alex31/paparazzi_minican/README.md

# MicroCAN

MicroCAN is a flexible UAVCAN interface card based on an STM32G491 microcontroller. It acts as a proxy between a UAVCAN network and a variety of peripherals such as servos, ESCs, sensors and serial links. The project contains both the bootloader and the main firmware used on the board.

## Features

- **UAVCAN slave node** with CAN FD support
- **Bootloader** able to update the firmware from an external M95P SPI flash memory with CRC checks for reliability
- **Servo control**: standard PWM outputs and support for smart servos
- **DShot ESC driver** with optional bi‑directional telemetry
- **SBUS tunnel** to forward RC frames over UAVCAN
- **Telemetry tunnel** for Paparazzi messages or raw serial data
- **I2C sensor support** (e.g. MPL3115A2 barometer)
- **Independent sensors**: IM68A130 microphone, OPT4060 RGBW and VL53L4CX range
  ([configuration](docs/software/roles/independent_sensors.md))
- **Health survey** publishing battery and core temperature measurements
- Configurable roles and parameters stored in persistent memory

Hardware design files are available under [HARDWARE/](HARDWARE/).

## Repository layout

- [bootloader/](bootloader/) – bootloader source code and configuration
- [microcan/](microcan/) – main application implementing the UAVCAN node and all roles
- [COMMON/](COMMON/) – modules shared between bootloader and application
- [HARDWARE/](HARDWARE/) – hardware schematics and CubeMX configuration
- [docs/](docs/) – software and hardware documentation

## Documentation

Start here: [docs/index.md](docs/index.md)

Related references:
- [roles.readme.txt](roles.readme.txt)

## Building

A GNU Arm embedded toolchain and ChibiOS 21.11 are required. The Makefiles expect this repository to reside next to a `ChibiOS_21.11_stable` folder. Run:

```bash
make            # builds bootloader and firmware
make flash       # flashes both images using bmpflash
```

You can also build `bootloader` or `microcan` individually by invoking `make -C bootloader` or `make -C microcan`.

For the very first flash over the STM32 ROM UART bootloader with a 3.3 V USB to
serial adapter, see [docs/software/build_flash.md](docs/software/build_flash.md).

## License

The vendored VL53L4CX component retains its [ST license](third_party/vl53l4cx/LICENSE.md)
and [source provenance](third_party/vl53l4cx/README.microcan.md).

This project includes ChibiOS components released under the Apache License 2.0. The rest of the code is provided without any specific license.
