alex31/paparazzi_minican/docs/hardware/overview.md

# Hardware Overview

This section documents the hardware platform and board files.

Key board files:
- [microcan/cfg/MICROCAN.cfg](../../microcan/cfg/MICROCAN.cfg) (pin map)
- [HARDWARE/MICROCAN/](../../HARDWARE/MICROCAN/) (schematics and board docs)

Onboard RGB LED behavior is defined in software. See:
- [docs/software/onboard_rgb_led.md](../software/onboard_rgb_led.md)
