alex31/paparazzi_minican/docs/software/roles/overview.md

# Role System and Roles

Role system overview:
- Roles are modular features enabled by parameters.
- Roles are compiled in if USE_*_ROLE in
  [COMMON/source/roleConf.h](../../../COMMON/source/roleConf.h) is true. The diagnostic shell uses `TRACE` (omitted with `NOSHELL=1`).
- Roles are instantiated at startup if their ROLE.* parameter is enabled.
- When ROLE.identification is true **at boot**, application roles remain stopped and UAVCAN
  runs in MAINTENANCE mode. Configuration, restart, dynamic ID allocation and
  firmware updates remain available; the onboard LED shows the purple motif.
  The shell remains available if `ROLE.shell=true`.
  Role parameters remain visible and retain their values. Disable identification,
  save and restart to resume the configured roles without reconfiguring them.
- After a normal boot, changing ROLE.identification only toggles the onboard
  LED between identification and node ID. Roles and UAVCAN mode are unchanged;
  the value is read at intervals of at most 200 ms. Use parameter write behavior 0 for a temporary
  change; behavior 1 saves it for the next boot, and behavior 2 reboots at once.
- Each role inherits RoleBase and implements subscribe() and start().
- Hardware resources are acquired via boardResource.tryAcquire(...).

Source reference: [roles.readme.txt](../../../roles.readme.txt) and
[COMMON/source/](../../../COMMON/source/) (files named *Role*).

## Roles (summary)

### ShellRole (ROLE.shell)
Enables the diagnostic console on J3 / LPUART1 at 115200 bit/s, 8N1.
Defaults to false; save and reboot. Its command buffers, history, statistics and
two thread stacks are allocated on activation. It also starts in identification mode when enabled.
See [shell.md](shell.md) for memory details and the test procedure.

### ServoRole (ROLE.servo.pwm, ROLE.servo.smart)
Receives uavcan.equipment.actuator.ArrayCommand and routes to PWM or smart servo
backend.

PWM params:
- role.servo.pwm.ch1-4.frequency
- role.servo.pwm.ch1-4.shot125
- role.servo.pwm.ch5-7.frequency
- role.servo.pwm.ch5-7.shot125
- role.servo.pwm.map_index1
- role.servo.pwm.channel_mask
  Bit mapping: bit0=PA08, bit1=PA09, bit2=PA10, bit3=PA11, bit4=PB04, bit5=PA04, bit6=PB07.

Smart servo params:
- role.servo.smart.map_index1
- role.servo.smart.num_servos
- role.servo.smart.status_frequency

Outputs:
- uavcan.equipment.actuator.Status (smart servo status only)

Wiring:
- PWM CH1..CH4 on TIM1 (PA08..PA11)
- PWM CH5..CH7 on TIM3 (PB04, PA04, PB07)
- Smart servos use UART (USART2 on MicroCAN)

Resource notes:
- Enabling any of CH5..CH7 reserves TIM3 for ServoPWM.
- CH5 on PB04 conflicts with USART2 RX (`UART_RX`).
- CH6 on PA04 conflicts with SPI peripheral chip select (`SPI_PERIPH_CS`).
- CH7 on PB07 conflicts with I2C1 SDA and with roles already documented on TIM3_CH4
  (LED strip, voltmeter).
- If only CH1..CH4 are enabled, ServoPWM stays on TIM1 and does not reserve TIM3.

### EscDshot (ROLE.esc.dshot)
Receives uavcan.equipment.esc.RawCommand and drives DShot on TIM1 CH1..CH4.

Params:
- role.esc.dshot.map_index1
- role.esc.dshot.channel_mask
- role.esc.dshot.cmd_rate (ChibiOS ticks)
- role.esc.dshot.rpm_freq_div (CAN publication divider; 0 disables publication)
- role.esc.dshot.motor_poles (even number from 2 to 100, default 2; common to all motors)
  Set to the motor's pole count, e.g. 14 for a 14-pole motor, and reboot the node.
  The default preserves the previous RPM scale; configure the actual pole count
  to obtain mechanical RPM for your motors. Odd values prevent the role from starting.

Telemetry:
- uavcan.equipment.esc.Status if bidirectional DShot is enabled.
- Every active channel's eRPM/EDT response is processed on each DShot cycle,
  including when CAN publication is disabled. The divider only limits CAN output.
- At each publication interval, channels with a valid eRPM received during that
  interval publish their latest mechanical RPM (`eRPM / (motor_poles / 2)`, rounded
  down) and fresh EDT data. Temperature is converted from Celsius to kelvin;
  voltage and current are published in volts and amperes. Missing measurements
  or measurements at least 3 seconds old are published as NaN, independently.
- With EDT enabled, stress maxima and status events are also published through
  dronecan.protocol.FlexDebug, at most 10 Hz per ESC. See the
  [freshness rules and MicroCAN payload format](dshot_telemetry.md).

Wiring:
- TIM1 CH1..CH4 on PA08..PA11 (MicroCAN)

### SBUS RC (ROLE.sbus)
Reads SBUS on UART and publishes dronecan.sensors.rc.RCInput.

Params:
- role.sbus.channel_mask
- role.sbus.id
- role.sbus.debug_uart_ttl (true: non-inverted TTL debug input, false: normal SBUS inversion)

Wiring:
- SBUS on USART2 RX (PB04) on MicroCAN

### SerialStream (ROLE.tunnel.serial)
UART <-> uavcan.tunnel.Broadcast bridge.

Params:
- role.tunnel.serial.protocol
- bus.serial.baudrate

Wiring:
- USART2 TX/RX on PB03/PB04 (MicroCAN)

### GpsUBX (ROLE.gnss.ubx)
Decodes UBX from UART and publishes:
- uavcan.equipment.gnss.Fix2 (NAV-PVT)
- uavcan.equipment.gnss.Auxiliary (DOP/SAT)

Params:
- bus.serial.baudrate

Notes:
- `bus.serial.baudrate > 0`: fixed UART baudrate.
- `bus.serial.baudrate = 0`: GNSS UBX auto-baud probing on `57600`, `115200`, `230400`.
- Detect baud, then configure GPS while keeping that detected baud.

The C++ decoder stores its callback configuration by reference. Its constructor
accepts `UBX::StaticDecoderConf`, whose `consteval` conversion checks the binding
at the call site. Keep the configuration in static storage, as in the existing
`GpsUBX::config` (`inline static constexpr`). Automatic configurations, including
local `constexpr` variables, heap configurations and temporaries are rejected.
The decoder itself can still be allocated dynamically.

Any intermediate factory must accept `UBX::StaticDecoderConf` by value rather
than an unchecked `const UBX::DecoderConf&`, so the check occurs at the original
call site. The wrapper is not stored in addition to the reference and does not
add per-decoder RAM. It checks the configuration object's lifetime, not callback
behavior or initialization of mutable global configurations.

Run `make -C microcan test_ubx_config_lifetime` for the positive and negative
compilation tests using the ARM compiler and the actual decoder header.

Wiring:
- USART2 TX/RX on PB03/PB04 (MicroCAN)

### QMC5883 Magnetometer (ROLE.i2c.magnetometer.q5883)
Publishes uavcan.equipment.ahrs.MagneticFieldStrength2.

Params:
- role.i2c.magnetometer.q5883.range (2 or 8 gauss)
- role.i2c.magnetometer.q5883.rot_deg (0/90/180/270)
- role.i2c.magnetometer.q5883.sensor_id

Wiring:
- I2C1 on PA15 (SCL) + PB07 (SDA)

### MPL3115A2 Barometer (ROLE.i2c.barometer.mpl3115a2)
Publishes uavcan.equipment.air_data.StaticPressure and StaticTemperature.

Wiring:
- I2C1 on PA15 (SCL) + PB07 (SDA)

### HealthSurvey (ROLE.health.survey)
Publishes board health:
- uavcan.equipment.device.Temperature
- uavcan.equipment.power.CircuitStatus (battery + 3.3V)

### LED Strip (ROLE.led2812)
Receives uavcan.equipment.indication.LightsCommand to drive WS2812 strip.

Params:
- role.led2812.led_number (1..8)

Wiring:
- TIM3_CH4 on PB07 (shared with voltmeter)

### Voltmeter (ROLE.voltmeter)
Displays battery status on WS2812 LED strip. Can blank LEDs based on GPS speed.

Params:
- role.voltmeter.cells
- role.voltmeter.brightness
- role.voltmeter.gps_speed_off_mps

Wiring:
- TIM3_CH4 on PB07 (shared with LED strip)

### TemplateRole (ROLE.template)
Minimal example role for developers. Subscribes to uavcan.protocol.NodeStatus and
optionally logs every N messages.

Params:
- role.template.log_every (0 disables logging)

See [docs/software/adding_roles.md](../adding_roles.md) for the full new role checklist.

## Independent microphone, RGBW and distance sensors

- `MicrophoneRole`: `ROLE.adc.microphone.im68a130`, PA4/ADC2/TIM6; electrical
  512-point Hann FFT and top-ten 100 Hz–3 kHz bins over
  `microcan.audio.Spectrum` (ID 20900): uint16 Hz and logarithmic uint16 level;
  the generic wire format supports up to 255 bins.
- `Opt4060Role`: `ROLE.i2c.light.opt4060`, shared I2C1 and optional PA8 INT;
  CRC-checked RGBW readings over `uavcan.protocol.debug.KeyValue`.
- `Vl53l4cxRole`: `ROLE.i2c.range.vl53l4cx`, shared I2C1;
  `uavcan.equipment.range_sensor.Measurement` in metres.

All are disabled by default and independent of IMAV. See
[independent sensors](independent_sensors.md) for parameters, telemetry units,
error handling and pin conflicts.
