alex31/paparazzi_minican/docs/hardware/boards/microcan_v5.md

# MicroCAN v5

Board: MicroCAN v5 (STM32G491K, 170 MHz, single-precision FPU).

Core peripherals:
- CAN FD with software selectable terminal resistor
- UART for GPS, serial tunnel, smart servo, etc.
- I2C for external peripherals, software selectable pullups
- SPI shared between internal M95P EEPROM and external peripherals
- TIM/PWM for servo, DShot, RGB LED strip
- Onboard RGB LED for node ID and status
- Debug pads with SWD and UART
- ADC monitoring for battery and 5V

Key files:
- [microcan/cfg/MICROCAN.cfg](../../../microcan/cfg/MICROCAN.cfg) (pin map)
- [HARDWARE/MICROCAN/](../../../HARDWARE/MICROCAN/) (schematics)
