alex31/paparazzi_minican/docs/software/compilation_toggles.md

# Compilation Toggles

Compile-time role toggles are defined in
[COMMON/source/roleConf.h](../../COMMON/source/roleConf.h):
- USE_SERVO_ROLE
- USE_BARO_MPL3115A2_ROLE
- USE_QMC5883_ROLE
- USE_ESC_DSHOT_ROLE
- USE_RC_SBUS_ROLE
- USE_GPS_UBX_ROLE
- USE_SERIAL_STREAM_ROLE
- USE_LED2812_ROLE
- USE_VOLTMETER_ROLE
- USE_TEMPLATE_ROLE
- USE_MICROPHONE_ROLE
- USE_OPT4060_ROLE
- USE_VL53L4CX_ROLE

These must be enabled for roles to be compiled in. Runtime enable is separate
and controlled by ROLE.* parameters.

The three new sensor switches accept make overrides (`USE_OPT4060_ROLE=0`,
for example). Use `make -C microcan clean` before changing make overrides.
They default to compiled-in, but their `ROLE.*` parameters
are false by default. See [independent sensors](roles/independent_sensors.md).
