alex31/paparazzi_minican/IMAV/sensors_electronic.odt

# Carte capteurs IMAV — document de travail

Version de discussion du 22 juillet 2026

Cible : MicroCAN v5 / STM32G491

Statut : proposition pour le premier prototype, à commenter en équipe

## 1. Balise cible et cadre IMAV 2026

### 1.1 Ce que fixe le règlement

La source de référence est le règlement IMAV 2026 v2.1, sections 5.4.7 et 5.4.8, page 34.

Sujet | Donnée utile pour le projet
Balise annoncée | MSA motionSCOUT K-T-R
Signal sonore | bande 2,6 à 3,0 kHz ; alarme annoncée à 95 dB à 3 m
Signal lumineux | deux LED très lumineuses ; le règlement ne précise ni leur couleur ni leur chronogramme
Zone de recherche | un point GPS donné le jour de l'épreuve ; trois mannequins dans un rayon de 25 m
Cible | un seul des trois mannequins porte la balise
Dépose | colis déposé ou largué à moins de 2 m d'altitude ; distance mesurée du nombril au colis, limitée à 50–300 cm pour le calcul
Enjeu de la détection | la partie principale du score est multipliée par deux près du bon mannequin
Autonomie | facteur 1 si tout est autonome, 0,7 avec calcul hors bord et 0,4 en cas d'action manuelle

Le texte conserve la mention « puissance sonore à définir » tout en donnant 95 dB à 3 m entre parenthèses. Cette valeur est donc notre base de travail, mais elle mérite une confirmation de l'organisation.

### 1.2 Comportement de la motionSCOUT K-T-R

Le manuel MSA 10251777/01 couvre toute la famille motionSCOUT et pas uniquement la balise de la compétition. Son tableau de commande associe explicitement la version motionSCOUT K avec les options T-R à la référence 10088478. C'est donc bien la variante visée par le règlement : version à clé (K), avec capteur de température (T) et réinitialisation manuelle de l'alarme (R).

D'après ce manuel :

1. le retrait de la clé active l'appareil et lance un autotest sonore et lumineux d'environ 2 s ;
2. après 25 s sans mouvement, une préalarme dure environ 15 s ; elle émet deux signaux sonores par seconde à niveau croissant et s'annule dès que la balise bouge ;
3. si l'immobilité continue, l'alarme complète démarre, soit environ 40 s après le dernier mouvement ; elle peut aussi être déclenchée immédiatement par le bouton d'alarme ;
4. l'alarme complète émet trois signaux sonores par seconde au niveau maximal et active les deux LED rouges d'alarme ; le manuel ne donne pas la cadence de ces LED ;
5. sur cette version R, deux appuis sur le bouton d'alarme en moins d'une seconde réinitialisent l'alarme ;
6. pour éteindre la version à clé, il faut réinsérer la clé puis maintenir le bouton ON/OFF pendant au moins 4 s.

La balise possède deux LED rouges d'alarme et une LED bicolore d'état distincte.

Une vidéo de démonstration de la motionSCOUT (https://www.youtube.com/shorts/VTjL53YFpTA) montre les deux LED d'alarme allumées simultanément pendant des impulsions de l'ordre de 100 ms, avec des cadences voisines de 1, puis 2, puis 3 allumages par seconde au cours de la séquence. Cette durée est assez longue pour une acquisition couleur périodique sans FIFO. La vidéo ne documente toutefois ni la référence exacte ni les conditions de prise de vue : ces valeurs sont des indications pour le prototype, pas des caractéristiques garanties de la balise de compétition.

La brochure MSA indique une bande de 2,6 à 3,0 kHz, comme le règlement, tandis que le manuel donne une bande plus large de 2,0 à 3,0 kHz. Le firmware utilise donc 2 600 Hz par défaut, conformément au règlement, mais expose le paramètre persistant role.imav.audio.band_low_hz, réglable de 2 000 à 2 600 Hz. La borne haute reste fixée à 3 000 Hz. La grille DSP ajoute une marge de 50 Hz de chaque côté et le nouveau réglage est pris en compte au redémarrage du rôle, donc en pratique après redémarrage de la MicroCAN.

Sources fabricant : brochure motionSCOUT (https://s7d9.scene7.com/is/content/minesafetyappliances/motionSCOUT%20Bulletin%20-%20FR), manuel MSA 10251777/01 et avis de service de février 2026 (https://assetlibrary.msasafety.com/m/1daafc2b15a7c2a5/original/Avis-de-service-Dispositif-MSA-motionSCOUT-PASS-Fevrier-2026.pdf).

Source d'observation complémentaire : vidéo YouTube de démonstration (https://www.youtube.com/shorts/VTjL53YFpTA).

### 1.3 Points à confirmer sur la balise de compétition

Le règlement et les documents MSA ne définissent pas :

- l'orientation et la fixation de la balise sur le mannequin ;
- les conditions réelles de soleil, de bruit, de vent et d'occultation pendant la mission ;

Il faut donc demander si possible une balise identique pour les essais, ou au minimum enregistrer l'exemplaire de compétition sous plusieurs angles et à plusieurs distances.

Un avis de service MSA de février 2026 inclut la référence 10088478 fabriquée entre juin 2024 et décembre 2025 : sur certaines unités, l'alarme sonore peut cesser alors que l'alarme visuelle continue de clignoter.

### 1.4 Conséquences pour notre détecteur

- La voie audio utilisera par défaut l'énergie dans la bande 2,6–3,0 kHz, mais sa borne basse pourra être abaissée jusqu'à 2,0 kHz pour les essais. La cadence caractéristique de trois signaux par seconde reste indispensable.
- La voie optique cherchera des variations rouges rapides et répétées. Une acquisition voisine de 100 Hz donnera environ dix mesures pendant un allumage de 100 ms observé dans la vidéo, sans imposer de FIFO.
- La LED d'état à 1 Hz n'est pas un indice de présence de la balise. Son éventuelle contribution au signal du capteur est un parasite qui ne doit pas déclencher la détection.
- Les détections sonore et lumineuse resteront indépendantes : leur accord augmentera la confiance, mais un ET strict risquerait de rejeter une vraie balise.
- L'exclusion temporelle entre mesure de lumière et mesure ToF ne sera validée qu'après mesure de la répétition réelle des éclairs et de la fenêtre aveugle.
- Comme une seule cible doit être distinguée parmi trois mannequins, la décision devra s'appuyer sur plusieurs mesures cohérentes dans l'espace, pas sur une détection instantanée isolée.

## 2. Contexte

Le module sera suspendu sous le drone par un fil de 2 à 3 m. Le drone volera à environ 3 à 4 m et la carte capteurs se trouvera approximativement à 1 m du sol. Elle doit aider à retrouver un mannequin couché équipé d'une balise sonore et lumineuse.

Le signal utile venant du sol, la proposition la plus simple est d'utiliser un seul capteur par fonction, tous orientés ou ouverts vers le bas :

- un microphone pour la balise sonore ;
- un capteur rapide pour les flashs ;
- un télémètre pour contrôler la hauteur du module au-dessus du sol.

Ce document présente la solution actuellement envisagée. Il ne constitue pas encore une spécification de fabrication définitive.

## 3. Proposition actuelle

Fonction | Composant retenu | Interface | Motivation principale
Son | Infineon IM68A130A | PA3 / ADC1_IN4 | microphone analogique sensible, un seul canal ADC
Flash | Texas Instruments OPT4060DTSR | I²C, adresse 0x44 | RGBW, forte réjection IR, plage automatique et alimentation directe en 3,3 V
Distance au sol | ST VL53L4CXV0DH/1 | I²C, adresse 0x29 | portée suffisante autour de 1 m et pilote officiel ST

Décisions déjà raisonnablement établies :

- un seul microphone et un seul capteur de flash ;
- OPT4060 et VL53L4CX orientés vers le sol ;
- microphone relié directement à l'ADC, sans amplificateur externe ;
- OPT4060 et VL53L4CX sur le même bus I²C ;
- bus à 400 kHz pour le premier prototype ;
- pull-up I²C de 2,2 kΩ déjà présentes sur la MicroCAN ;
- aucune mesure de lumière pendant une mesure ToF ;
- tous les capteurs alimentés directement par le rail 3,3 V ;
- acquisition du capteur de lumière par lecture périodique, sans FIFO ;
- sortie d'interruption de l'OPT4060 facultative pour le premier prototype.

Ce choix supprime le régulateur 1,8 V et la dépendance au TCS34103M en phase « Last Time Buy ». Il conserve une information de couleur utile pour distinguer les LED rouges de variations générales de l'éclairage ambiant.

## 4. Utilisation envisagée des capteurs

### 4.1 Microphone

L'IM68A130A fournit déjà un signal analogique amplifié et polarisé autour de 1,3 V. Il peut donc être relié directement à l'ADC 0–3,3 V :

- pas de condensateur de liaison ;
- pas de pont de polarisation ;
- pas d'OPAMP ;
- un simple filtrage passif de l'alimentation et une petite résistance série devant l'ADC.

L'indicateur sonore proposé pour discriminer la balise du bruit des moteurs est le rapport :

10 × log10(énergie dans les bandes de la balise / énergie audio totale)

La borne basse utilisée par ce calcul vient de role.imav.audio.band_low_hz : plage 2 000–2 600 Hz, valeur par défaut 2 600 Hz. Ce paramètre est exposé par UAVCAN et sauvegardé dans la mémoire persistante avec le mécanisme commun de la MicroCAN. Un redémarrage est requis après sa modification.

Il faudra lui ajouter un seuil minimal d'énergie absolue pour éviter qu'un rapport élevé calculé sur du silence soit interprété comme une détection. Les largeurs de bandes et les seuils devront être déterminés à partir d'enregistrements réels sous le drone. La présence d'une enveloppe répétée à environ 3 Hz permettra de renforcer la détection de l'alarme complète ; la préalarme à 2 Hz ne doit pas être notre état nominal de recherche.

### 4.2 Flash

L'OPT4060 fonctionne directement sous 3,3 V et fournit quatre voies : rouge, verte, bleue et large bande. Les voies RGB possèdent une forte réjection du proche infrarouge. La sélection automatique de plage doit faciliter le passage de l'ombre au soleil sans réglage permanent du gain.

Pour le premier prototype, la configuration proposée est :

- temps de conversion de 1,8 ms par voie, soit 7,2 ms pour un cycle RGBW ;
- mode continu et lecture périodique proche de 100 Hz sur l'I²C à 400 kHz ;
- plage automatique activée ;
- pas de FIFO et pas d'interruption obligatoire.

À 100 Hz, un allumage d'environ 100 ms observé dans la vidéo produit une dizaine de mesures. La détection pourra combiner :

- une variation positive de la voie rouge par rapport à un fond ambiant lent ;
- un seuil minimal absolu pour rejeter le bruit de mesure ;
- une chromaticité dominée par le rouge, comparée aux voies verte, bleue et large bande ;
- la répétition temporelle attendue de l'alarme complète, voisine de 3 Hz.

La LED d'état rouge à 1 Hz ne devra jamais suffire à valider la détection. Les seuils et les rapports de couleur seront déterminés à partir de mesures sur la vraie balise, en intérieur puis en plein soleil.

### 4.3 Distance au sol

Le VL53L4CX effectuera une mesure ponctuelle, typiquement toutes les 200 ms. L'acquisition de l'OPT4060 sera suspendue avant l'émission infrarouge 940 nm, puis reprise après la mesure. Les échantillons optiques présents autour de cette fenêtre seront ignorés.

Cette stratégie simplifie l'électronique et évite les interactions optiques, mais crée une fenêtre aveugle de plusieurs dizaines de millisecondes pour les flashs. Les allumages assez longs visibles dans la vidéo rendent cette stratégie plausible, mais son acceptabilité devra être vérifiée sur la vraie balise.

## 5. Schéma électrique minimal proposé

+3V3 --------------------------------------------------------------+
| |
+-- 10 µF + 100 nF près du connecteur |
| |
+-- 22 Ω -- IM68A130A VDD |
| +-- 1 µF + 100 nF vers GND |
| |
+---------------------------- OPT4060 VDD |
| +-- 100 nF vers GND |
| |
+---------------------------- VL53L4CX AVDD + AVDDVCSEL |
+-- 100 nF + 4,7 µF vers GND |
|
IM68A130A OUT -- 100 Ω -- MIC_ADC -- PA3 / ADC1_IN4 |
|
OPT4060 ADDR ------------------------------------------------ GND |
OPT4060 INT ------------------------------------------ point de test|
|
MicroCAN SDA ------------------- OPT4060 SDA + VL53L4CX SDA |
MicroCAN SCL ------------------- OPT4060 SCL + VL53L4CX SCL |
GND ------------------------------------------------ plan continu --+

Points à conserver dans le schéma du premier prototype :

Élément | Proposition de départ
Entrée 3,3 V | 10 µF + 100 nF près du connecteur
Microphone | alimentation via 22 Ω, 1 µF + 100 nF, sortie via 100 Ω
Filtre ADC optionnel | empreinte 47 à 100 pF, non montée initialement
OPT4060 | VDD sur 3,3 V, 100 nF au plus près, ADDR à GND pour l'adresse 0x44
OPT4060 INT | point de test ou broche optionnelle, non nécessaire au fonctionnement initial
VL53L4CX | 100 nF + 4,7 µF, XSHUT tiré à 3,3 V par 10 kΩ
SDA/SCL | résistances série 0 Ω ; pull-up locales prévues mais non montées

Le VL53L4CX impose les pointes de courant les plus fortes. Le connecteur, le faisceau et le rail 3,3 V seront dimensionnés pour au moins 60 mA.

## 6. Connexion à la MicroCAN

La proposition utilise un connecteur verrouillable à six contacts et un petit faisceau en Y vers J3 et J5 de la MicroCAN.

Signal carte capteurs | Destination MicroCAN
GND_AUDIO | J3 broche 1
MIC_ADC | J3 broche 7 — PA3 / ADC1_IN4
GND_I2C | J5 broche 1
+3V3 | J5 broche 3
SDA | J5 broche 4 — PB7 / I2C1_SDA
SCL | J5 broche 5 — PA15 / I2C1_SCL

Le +5 V de J5 n'est pas utilisé. MIC_ADC devra cheminer avec GND_AUDIO et être tenu à distance des fils moteur, PWM et alimentation de puissance.

La famille exacte du connecteur reste à choisir avec l'équipe mécanique et en fonction des connecteurs réellement montés sur la MicroCAN.

## 7. Implantation mécanique proposée

- OPT4060 et VL53L4CX sur la face inférieure, orientés vers le sol.
- Cloison noire entre les deux capteurs optiques.
- Microphone sur l'autre face avec un trou acoustique non métallisé de 0,6 mm vers le sol, sous réserve de validation de la variante exacte du microphone.
- Aucun composant, vernis, colle ou sérigraphie devant les surfaces sensibles.
- Keep-out séparés pour les deux zones optiques et le trou acoustique.
- Pour le premier prototype, ouvertures directes sans vitre ni diffuseur afin de limiter les inconnues.
- Une carte quatre couches est préférable pour conserver un plan de masse continu, mais une carte deux couches reste à discuter si la géométrie est simple.

Les dimensions de carte, les fixations, la masse cible et la protection contre le vent ne sont pas encore définies.

## 8. Disponibilité observée au 22 juillet 2026

Les stocks évoluent rapidement ; ce tableau sert uniquement à éviter de figer une référence impossible à acheter en petite quantité.

Référence | Situation observée | Conséquence proposée
IM68A130AXTMA1 (https://www.digikey.fr/fr/products/detail/infineon-technologies/IM68A130AXTMA1/20115168) | actif, mais stock nul chez Mouser et DigiKey lors de la vérification | vérifier un autre distributeur ou la variante V01
IM68A130V01XTMA1 (https://www.mouser.fr/ProductDetail/Infineon-Technologies/IM68A130V01XTMA1) | actif et préféré, environ 4 100 pièces chez Mouser, vente à l'unité | candidat de remplacement à valider mécaniquement
OPT4060DTSR (https://www.digikey.com/en/products/detail/texas-instruments/OPT4060DTSR/22116843) | actif, plusieurs milliers de pièces disponibles à l'unité chez DigiKey et Mouser | choix retenu pour le capteur de flash
APDS-9253-001 (https://www.digikey.com/en/products/detail/broadcom-limited/APDS-9253-001/10135044) | actif, plusieurs milliers de pièces disponibles à l'unité | repli RGB + IR sous 3,3 V, limité à environ 40 mesures/s
VEML3328 (https://www.mouser.com/ProductDetail/Vishay-Semiconductors/VEML3328) | actif et très largement disponible | repli très simple, mais intégration minimale de 50 ms
TCS34103M / Q65114A1293 (https://www.digikey.com/en/products/detail/ams-osram-usa-inc/TCS34103M-OLGA6-LF-T-RDP/14123872) | disponible mais en phase Last Time Buy | écarté : rail 1,8 V et FIFO devenus inutiles
VL53L4CXV0DH/1 (https://www.mouser.com/ProductDetail/STMicroelectronics/VL53L4CXV0DH-1) | plusieurs milliers de pièces chez Mouser et Farnell | pas de risque immédiat identifié

Le choix fonctionnel du microphone reste la famille IM68A130. Avant de libérer le PCB, il faudra confirmer si la qualification automobile de l'IM68A130A est utile pour cette compétition ou si l'IM68A130V01, beaucoup plus disponible, convient. Le symbole, le port acoustique et le land pattern devront être comparés sur les fiches techniques officielles avant substitution.

## 9. Questions à discuter

## 10. Essais proposés avant de figer la carte

- Est-ce qu’on aura une balise pour faire des tests à l’Enac ?

## 11. Documents de référence

Documents du projet :

- étude système ;
- schéma MicroCAN v5 ;
- acquisition et détection audio ;
- gestion lumière et distance.

Fiches fabricants :

- Infineon IM68A130A (https://www.infineon.com/assets/row/public/documents/24/49/infineon-im68a130a-datasheet-en.pdf) ;
- Infineon IM68A130V01 (https://www.infineon.com/assets/row/public/documents/24/49/infineon-im68a130-datasheet-en.pdf) ;
- Texas Instruments OPT4060 (https://www.ti.com/lit/ds/symlink/opt4060.pdf) ;
- Broadcom APDS-9253-001 (https://www.broadcom.com/products/optical-sensors/ambient-light-photo-sensors/apds-9253-001) ;
- Vishay VEML3328 (https://www.vishay.com/docs/84968/veml3328.pdf) ;
- ST VL53L4CX (https://www.st.com/resource/en/datasheet/vl53l4cx.pdf).

Observation vidéo non normative :

- vidéo YouTube de démonstration de la motionSCOUT (https://www.youtube.com/shorts/VTjL53YFpTA).
