alex31/paparazzi_minican/HARDWARE/MICROCAN/MicroCAN_v5.pdf

28/07/2025

MiniCAN_v5 Project
Configuration Report

## 1. Description

### 1.1. Project

Project Name | MiniCAN_v5
Board Name | custom
Generated with: | STM32CubeMX 6.15.0
Date | 07/28/2025

### 1.2. MCU

MCU Series | STM32G4
MCU Line | STM32G4x1
MCU name | STM32G491KEUx
MCU Package | UFQFPN32
MCU Pin number | 32

### 1.3. Core(s) information

Core(s) | ARM Cortex-M4

## 2. Pinout Configuration

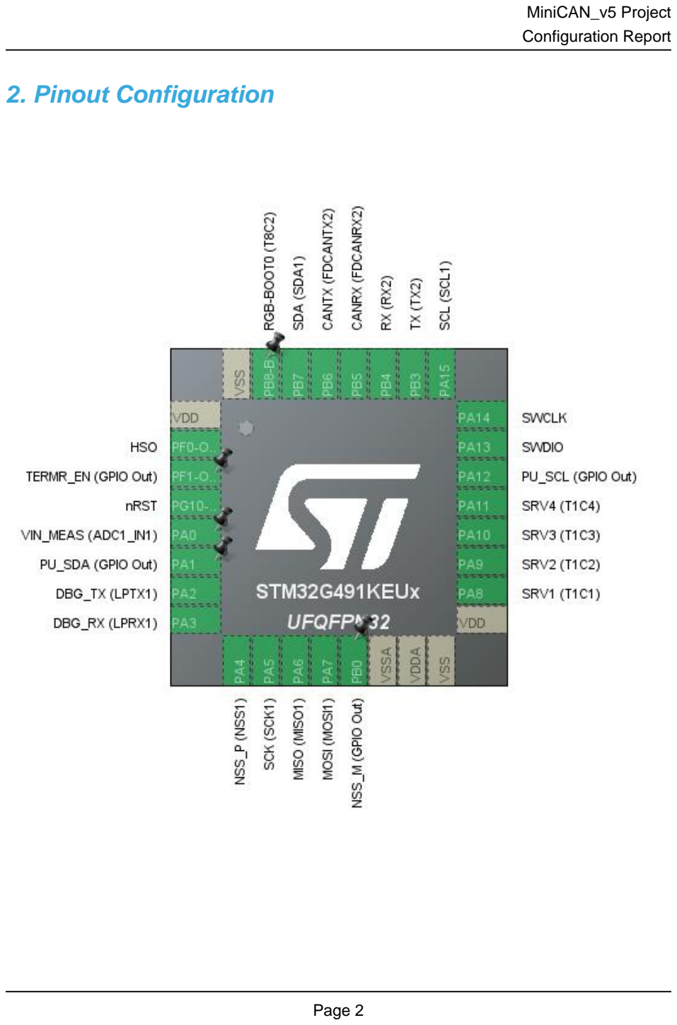
[picture p2: page 3]

## 3. Pins Configuration

Pin Number UFQFPN32 | Pin Name (function after reset) | Pin Type | Alternate Function(s) | Label
1 | VDD | Power
2 | PF0-OSC_IN | I/O | RCC_OSC_IN | HSO
3 | PF1-OSC_OUT * | I/O | GPIO_Output | TERMR_EN (GPIO Out)
4 | PG10-NRST * | I/O | GPIO_Input | nRST
5 | PA0 | I/O | ADC1_IN1 | VIN_MEAS (ADC1_IN1)
6 | PA1 * | I/O | GPIO_Output | PU_SDA (GPIO Out)
7 | PA2 | I/O | LPUART1_TX | DBG_TX (LPTX1)
8 | PA3 | I/O | LPUART1_RX | DBG_RX (LPRX1)
9 | PA4 | I/O | SPI1_NSS | NSS_P (NSS1)
10 | PA5 | I/O | SPI1_SCK | SCK (SCK1)
11 | PA6 | I/O | SPI1_MISO | MISO (MISO1)
12 | PA7 | I/O | SPI1_MOSI | MOSI (MOSI1)
13 | PB0 * | I/O | GPIO_Output | NSS_M (GPIO Out)
14 | VSSA | Power
15 | VDDA | Power
16 | VSS | Power
17 | VDD | Power
18 | PA8 | I/O | TIM1_CH1 | SRV1 (T1C1)
19 | PA9 | I/O | TIM1_CH2 | SRV2 (T1C2)
20 | PA10 | I/O | TIM1_CH3 | SRV3 (T1C3)
21 | PA11 | I/O | TIM1_CH4 | SRV4 (T1C4)
22 | PA12 * | I/O | GPIO_Output | PU_SCL (GPIO Out)
23 | PA13 | I/O | SYS_JTMS-SWDIO | SWDIO
24 | PA14 | I/O | SYS_JTCK-SWCLK | SWCLK
25 | PA15 | I/O | I2C1_SCL | SCL (SCL1)
26 | PB3 | I/O | USART2_TX | TX (TX2)
27 | PB4 | I/O | USART2_RX | RX (RX2)
28 | PB5 | I/O | FDCAN2_RX | CANRX (FDCANRX2)
29 | PB6 | I/O | FDCAN2_TX | CANTX (FDCANTX2)
30 | PB7 | I/O | I2C1_SDA | SDA (SDA1)
31 | PB8-BOOT0 | I/O | TIM8_CH2 | RGB-BOOT0 (T8C2)
32 | VSS | Power

* The pin is affected with an I/O function

## 4. Clock Tree Configuration

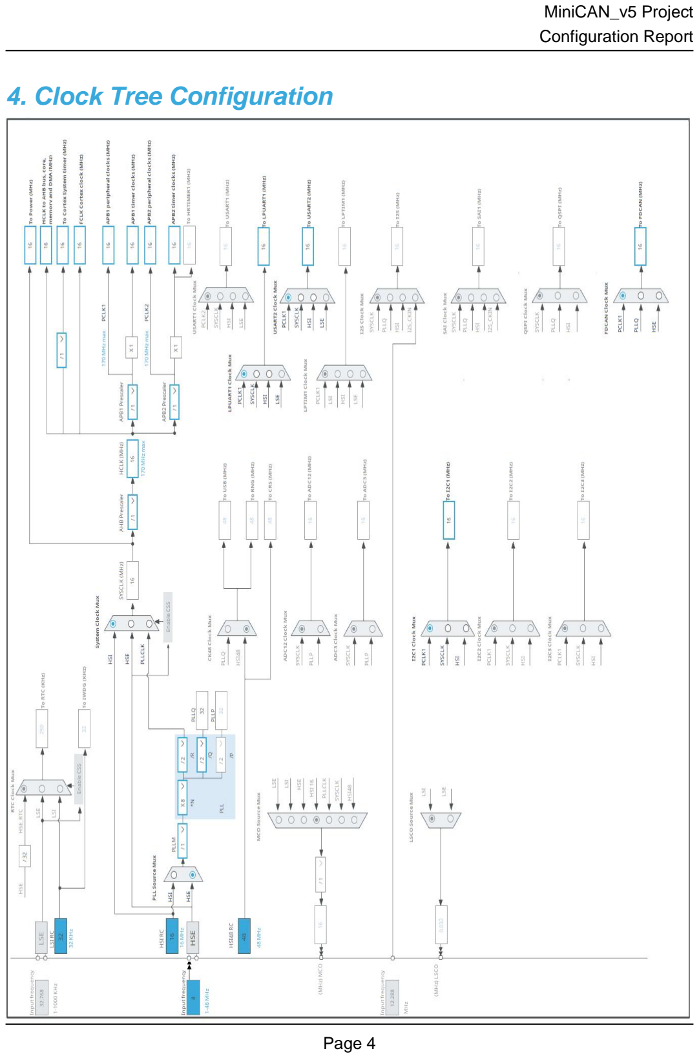
[picture p3: page 5]

## 1. Power Consumption Calculator report

### 1.1. Microcontroller Selection

Series | STM32G4
Line | STM32G4x1
MCU | STM32G491KEUx
Datasheet | DS13122_Rev1

### 1.2. Parameter Selection

Temperature | 25
Vdd | 3.3

### 1.3. Battery Selection

Battery | Li-SOCL2(A3400)
Capacity | 3400.0 mAh
Self Discharge | 0.08 %/month
Nominal Voltage | 3.6 V
Max Cont Current | 100.0 mA
Max Pulse Current | 200.0 mA
Cells in series | 1
Cells in parallel | 1

### 1.4. Sequence

Step | Step1 | Step2
Mode | RUN | STOP1
Vdd | 3.3 | 3.3
Voltage Source | Battery | Battery
Range | Range1-Boost | NoRange
Fetch Type | FLASH/ART | NA
CPU Frequency | 170 MHz | 0 Hz
Clock Configuration | HSE BYP PLL | LSE LowDrive RTC
Clock Source Frequency | 4 MHz | 32.768 kHz
Peripherals
Additional Cons. | 0 mA | 0 mA
Average Current | 26.4 mA | 57.3 µA
Duration | 0.1 ms | 0.9 ms
DMIPS | 213.0 | 0.0
Ta Max | 145.21 | 149.99
Category | In DS Table | In DS Table

### 1.5. Results

Sequence Time | 1 ms | Average Current | 2.69 mA
Battery Life | 1 month, 22 days, 3 hours | Average DMIPS | 212.5 DMIPS

### 1.6. Chart

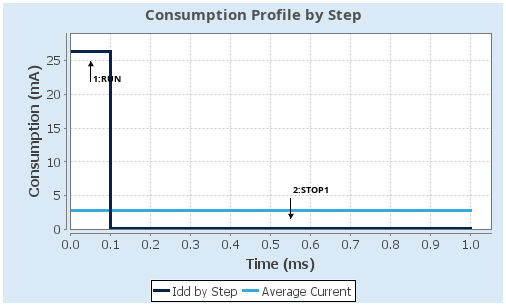
[picture p4: figure]

## 2. Software Project

### 2.1. Project Settings

Name | Value
Project Name | MiniCAN_v5
Project Folder | /home/alex/DEV/STM32/CHIBIOS/C21DEV/MINICAN/MINICAN_V5_MICROCAN
Toolchain / IDE | EWARM V8.50
Firmware Package Name and Version | STM32Cube FW_G4 V1.6.1
Application Structure | Advanced
Generate Under Root | No
Do not generate the main() | No
Minimum Heap Size | 0x200
Minimum Stack Size | 0x400

### 2.2. Code Generation Settings

Name | Value
STM32Cube MCU packages and embedded software | Copy all used libraries into the project folder
Generate peripheral initialization as a pair of '.c/.h' files | No
Backup previously generated files when re-generating | No
Keep User Code when re-generating | Yes
Delete previously generated files when not re-generated | Yes
Set all free pins as analog (to optimize the power consumption) | No
Enable Full Assert | No

### 2.3. Advanced Settings - Generated Function Calls

Rank | Function Name | Peripheral Instance Name
1 | SystemClock_Config | RCC
2 | MX_GPIO_Init | GPIO
3 | MX_LPUART1_UART_Init | LPUART1
4 | MX_TIM1_Init | TIM1
5 | MX_FDCAN2_Init | FDCAN2
6 | MX_I2C1_Init | I2C1
7 | MX_USART2_UART_Init | USART2
8 | MX_SPI1_Init | SPI1
9 | MX_ADC1_Init | ADC1
10 | MX_TIM8_Init | TIM8

## 3. Peripherals and Middlewares Configuration

### 3.1. ADC1

IN1: IN1 Single-ended
3.1.1. Parameter Settings:

ADCs_Common_Settings:

Mode | Independent mode
ADC_Settings:
Clock Prescaler | Synchronous clock mode divided by 2
Resolution | ADC 12-bit resolution
Data Alignment | Right alignment
Gain Compensation | 0
Scan Conversion Mode | Disabled
End Of Conversion Selection | End of single conversion
Low Power Auto Wait | Disabled
Continuous Conversion Mode | Disabled
Discontinuous Conversion Mode | Disabled
DMA Continuous Requests | Disabled
Overrun behaviour | Overrun data preserved
ADC_Regular_ConversionMode:
Enable Regular Conversions | Enable
Enable Regular Oversampling | Disable
Number Of Conversion | 1
External Trigger Conversion Source | Regular Conversion launched by software
External Trigger Conversion Edge | None
Rank | 1
Channel | Channel 1
Sampling Time | 2.5 Cycles
Offset Number | No offset
ADC_Injected_ConversionMode:
Enable Injected Conversions | Disable
Analog Watchdog 1:
Enable Analog WatchDog1 Mode | false
Analog Watchdog 2:
Enable Analog WatchDog2 Mode | false
Analog Watchdog 3:
Enable Analog WatchDog3 Mode | false

### 3.2. FDCAN2

mode: Activated
3.2.1. Parameter Settings:

Basic Parameters:

Clock Divider | Divide kernel clock by 1
Frame Format | Classic mode
Mode | Normal mode
Auto Retransmission | Disable
Transmit Pause | Disable
Protocol Exception | Disable
Nominal Sync Jump Width | 1
Data Prescaler | 1
Data Sync Jump Width | 1
Data Time Seg1 | 1
Data Time Seg2 | 1
Std Filters Nbr | 0
Ext Filters Nbr | 0
Tx Fifo Queue Mode | FIFO mode
Bit Timings Parameters:
Nominal Prescaler | 16
Nominal Time Quantum | 1000.0 *
Nominal Time Seg1 | 1
Nominal Time Seg2 | 1
Nominal Time for one Bit | 3000 *
Nominal Baud Rate | 333333 *

### 3.3. I2C1

I2C: I2C
3.3.1. Parameter Settings:

Timing configuration:

Custom Timing | Disabled
I2C Speed Mode | Standard Mode
I2C Speed Frequency (KHz) | 100
Rise Time (ns) | 100
Fall Time (ns) | 100
Coefficient of Digital Filter | 0

Analog Filter | Enabled
Timing | 0x00303D5B
Slave Features:
Clock No Stretch Mode | Disabled
General Call Address Detection | Disabled
Primary Address Length selection | 7-bit
Dual Address Acknowledged | Disabled
Primary slave address | 0

### 3.4. LPUART1

Mode: Asynchronous
3.4.1. Parameter Settings:

Basic Parameters:

Baud Rate | 209700
Word Length | 8 Bits (including Parity)
Parity | None
Stop Bits | 1
Advanced Parameters:
Data Direction | Receive and Transmit
Single Sample | Disable
ClockPrescaler | 1
Fifo Mode | FIFO mode disable
Txfifo Threshold | 1 eighth full configuration
Rxfifo Threshold | 1 eighth full configuration
Advanced Features:
TX Pin Active Level Inversion | Disable
RX Pin Active Level Inversion | Disable
Data Inversion | Disable
TX and RX pins Swapping | Disable
Overrun | Enable
DMA on RX Error | Enable
MSB First | Disable

### 3.5. RCC

High Speed Clock (HSE): BYPASS Clock Source
3.5.1. Parameter Settings:

System Parameters:

VDD voltage (V) | 3.3
Instruction Cache | Enabled
Prefetch Buffer | Disabled
Data Cache | Enabled
Flash Latency(WS) | 0 WS (1 CPU cycle)
RCC Parameters:
HSI Calibration Value | 64
HSE Startup Timout Value (ms) | 100
LSE Startup Timout Value (ms) | 5000
Power Parameters:
Power Regulator Voltage Scale | Power Regulator Voltage Scale 1
Peripherals Clock Configuration:
Generate the peripherals clock configuration | TRUE

### 3.6. SPI1

Mode: Full-Duplex Slave
Hardware NSS Signal: Hardware NSS Input Signal
3.6.1. Parameter Settings:

Basic Parameters:

Frame Format | Motorola
Data Size | 4 Bits
First Bit | MSB First
Clock Parameters:
Clock Polarity (CPOL) | Low
Clock Phase (CPHA) | 1 Edge
Advanced Parameters:
CRC Calculation | Disabled
NSS Signal Type | Input Hardware

### 3.7. SYS

Debug: Serial Wire
Timebase Source: SysTick
mode: save power of non-active UCPD - deactive Dead Battery pull-up

### 3.8. TIM1

Channel1: PWM Generation CH1 Channel2: PWM Generation CH2 Channel3: PWM Generation CH3 Channel4: PWM Generation CH4
3.8.1. Parameter Settings:

Counter Settings:

Prescaler (PSC - 16 bits value) | 0
Counter Mode | Up
Dithering | Disable
Counter Period (AutoReload Register - 16 bits value ) | 65535
Internal Clock Division (CKD) | No Division
Repetition Counter (RCR - 16 bits value) | 0
auto-reload preload | Disable
Trigger Output (TRGO) Parameters:
Master/Slave Mode (MSM bit) | Disable (Trigger input effect not delayed)
Trigger Event Selection TRGO | Reset (UG bit from TIMx_EGR)
Trigger Event Selection TRGO2 | Reset (UG bit from TIMx_EGR)
Break And Dead Time management - BRK Configuration:
BRK State | Disable
BRK Polarity | High
BRK Filter (4 bits value) | 0
BRK Sources Configuration
- Digital Input | Disable
- COMP1 | Disable
- COMP2 | Disable
- COMP3 | Disable
- COMP4 | Disable
Break And Dead Time management - BRK2 Configuration:
BRK2 State | Disable
BRK2 Polarity | High
BRK2 Filter (4 bits value) | 0
BRK2 Sources Configuration
- Digital Input | Disable
- COMP1 | Disable
- COMP2 | Disable
- COMP3 | Disable
- COMP4 | Disable

Break And Dead Time management - Output Configuration:

Automatic Output State | Disable
Off State Selection for Run Mode (OSSR) | Disable
Off State Selection for Idle Mode (OSSI) | Disable
Lock Configuration | Off
Clear Input:
Clear Input Source | Disable
PWM Generation Channel 1:
Mode | PWM mode 1
Pulse (16 bits value) | 0
Output compare preload | Enable
Fast Mode | Disable
CH Polarity | High
CH Idle State | Reset
PWM Generation Channel 2:
Mode | PWM mode 1
Pulse (16 bits value) | 0
Output compare preload | Enable
Fast Mode | Disable
CH Polarity | High
CH Idle State | Reset
PWM Generation Channel 3:
Mode | PWM mode 1
Pulse (16 bits value) | 0
Output compare preload | Enable
Fast Mode | Disable
CH Polarity | High
CH Idle State | Reset
PWM Generation Channel 4:
Mode | PWM mode 1
Pulse (16 bits value) | 0
Output compare preload | Enable
Fast Mode | Disable
CH Polarity | High
CH Idle State | Reset

### 3.9. TIM8

Channel2: PWM Generation CH2
3.9.1. Parameter Settings:

Counter Settings:

Prescaler (PSC - 16 bits value) | 0
Counter Mode | Up
Dithering | Disable
Counter Period (AutoReload Register - 16 bits value ) | 65535
Internal Clock Division (CKD) | No Division
Repetition Counter (RCR - 16 bits value) | 0
auto-reload preload | Disable
Trigger Output (TRGO) Parameters:
Master/Slave Mode (MSM bit) | Disable (Trigger input effect not delayed)
Trigger Event Selection TRGO | Reset (UG bit from TIMx_EGR)
Trigger Event Selection TRGO2 | Reset (UG bit from TIMx_EGR)
Break And Dead Time management - BRK Configuration:
BRK State | Disable
BRK Polarity | High
BRK Filter (4 bits value) | 0
BRK Sources Configuration
- Digital Input | Disable
- COMP1 | Disable
- COMP2 | Disable
- COMP3 | Disable
- COMP4 | Disable
Break And Dead Time management - BRK2 Configuration:
BRK2 State | Disable
BRK2 Polarity | High
BRK2 Filter (4 bits value) | 0
BRK2 Sources Configuration
- Digital Input | Disable
- COMP1 | Disable
- COMP2 | Disable
- COMP3 | Disable
- COMP4 | Disable
Break And Dead Time management - Output Configuration:
Automatic Output State | Disable
Off State Selection for Run Mode (OSSR) | Disable
Off State Selection for Idle Mode (OSSI) | Disable
Lock Configuration | Off
Clear Input:
Clear Input Source | Disable
PWM Generation Channel 2:

Mode | PWM mode 1
Pulse (16 bits value) | 0
Output compare preload | Enable
Fast Mode | Disable
CH Polarity | High
CH Idle State | Reset

### 3.10. USART2

Mode: Asynchronous
3.10.1. Parameter Settings:

Basic Parameters:

Baud Rate | 115200
Word Length | 8 Bits (including Parity)
Parity | None
Stop Bits | 1
Advanced Parameters:
Data Direction | Receive and Transmit
Over Sampling | 16 Samples
Single Sample | Disable
ClockPrescaler | 1
Fifo Mode | Disable
Txfifo Threshold | 1 eighth full configuration
Rxfifo Threshold | 1 eighth full configuration
Advanced Features:
Auto Baudrate | Disable
TX Pin Active Level Inversion | Disable
RX Pin Active Level Inversion | Disable
Data Inversion | Disable
TX and RX Pins Swapping | Disable
Overrun | Enable
DMA on RX Error | Enable
MSB First | Disable

* User modified value

## 4. System Configuration

### 4.1. GPIO configuration

IP | Pin | Signal | GPIO mode | GPIO pull/up pull down | Max Speed | User Label
ADC1 | PA0 | ADC1_IN1 | Analog mode | No pull-up and no pull-down | n/a | VIN_MEAS (ADC1_IN1)
FDCAN2 | PB5 | FDCAN2_RX | Alternate Function Push Pull | No pull-up and no pull-down | Low | CANRX (FDCANRX2)
| PB6 | FDCAN2_TX | Alternate Function Push Pull | No pull-up and no pull-down | Low | CANTX (FDCANTX2)
I2C1 | PA15 | I2C1_SCL | Alternate Function Open Drain | No pull-up and no pull-down | Low | SCL (SCL1)
| PB7 | I2C1_SDA | Alternate Function Open Drain | No pull-up and no pull-down | Low | SDA (SDA1)
LPUART1 | PA2 | LPUART1_TX | Alternate Function Push Pull | No pull-up and no pull-down | Low | DBG_TX (LPTX1)
| PA3 | LPUART1_RX | Alternate Function Push Pull | No pull-up and no pull-down | Low | DBG_RX (LPRX1)
RCC | PF0-OSC_IN | RCC_OSC_IN | n/a | n/a | n/a | HSO
SPI1 | PA4 | SPI1_NSS | Alternate Function Push Pull | No pull-up and no pull-down | Low | NSS_P (NSS1)
| PA5 | SPI1_SCK | Alternate Function Push Pull | No pull-up and no pull-down | Low | SCK (SCK1)
| PA6 | SPI1_MISO | Alternate Function Push Pull | No pull-up and no pull-down | Low | MISO (MISO1)
| PA7 | SPI1_MOSI | Alternate Function Push Pull | No pull-up and no pull-down | Low | MOSI (MOSI1)
SYS | PA13 | SYS_JTMS-SWDIO | n/a | n/a | n/a | SWDIO
| PA14 | SYS_JTCK-SWCLK | n/a | n/a | n/a | SWCLK
TIM1 | PA8 | TIM1_CH1 | Alternate Function Push Pull | No pull-up and no pull-down | Low | SRV1 (T1C1)
| PA9 | TIM1_CH2 | Alternate Function Push Pull | No pull-up and no pull-down | Low | SRV2 (T1C2)
| PA10 | TIM1_CH3 | Alternate Function Push Pull | No pull-up and no pull-down | Low | SRV3 (T1C3)
| PA11 | TIM1_CH4 | Alternate Function Push Pull | No pull-up and no pull-down | Low | SRV4 (T1C4)
TIM8 | PB8-BOOT0 | TIM8_CH2 | Alternate Function Push Pull | No pull-up and no pull-down | Low | RGB-BOOT0 (T8C2)
USART2 | PB3 | USART2_TX | Alternate Function Push Pull | No pull-up and no pull-down | Low | TX (TX2)
| PB4 | USART2_RX | Alternate Function Push Pull | No pull-up and no pull-down | Low | RX (RX2)
GPIO | PF1-OSC_OUT | GPIO_Output | Output Push Pull | No pull-up and no pull-down | Low | TERMR_EN (GPIO Out)
| PG10-NRST | GPIO_Input | Input mode | No pull-up and no pull-down | n/a | nRST
| PA1 | GPIO_Output | Output Push Pull | No pull-up and no pull-down | Low | PU_SDA (GPIO Out)
| PB0 | GPIO_Output | Output Push Pull | No pull-up and no pull-down | Low | NSS_M (GPIO Out)
| PA12 | GPIO_Output | Output Push Pull | No pull-up and no pull-down | Low | PU_SCL (GPIO Out)

### 4.2. DMA configuration

nothing configured in DMA service

### 4.3. NVIC configuration

4.3.1. NVIC
Interrupt Table | Enable | Preenmption Priority | SubPriority
Non maskable interrupt | true | 0 | 0
Hard fault interrupt | true | 0 | 0
Memory management fault | true | 0 | 0
Prefetch fault, memory access fault | true | 0 | 0
Undefined instruction or illegal state | true | 0 | 0
System service call via SWI instruction | true | 0 | 0
Debug monitor | true | 0 | 0
Pendable request for system service | true | 0 | 0
System tick timer | true | 15 | 0
PVD/PVM1/PVM2/PVM3/PVM4 interrupts through EXTI lines 16/38/39/40/41 | | unused
Flash global interrupt | | unused
RCC global interrupt | | unused
ADC1 and ADC2 global interrupt | | unused
TIM1 break interrupt and TIM15 global interrupt | | unused
TIM1 update interrupt and TIM16 global interrupt | | unused
TIM1 trigger and commutation interrupts and TIM17 global interrupt | | unused
TIM1 capture compare interrupt | | unused
I2C1 event interrupt / I2C1 wake-up interrupt through EXTI line 23 | | unused
I2C1 error interrupt | | unused
SPI1 global interrupt | | unused
USART2 global interrupt / USART2 wake-up interrupt through EXTI line 26 | | unused
TIM8 break interrupt | | unused
TIM8 update interrupt | | unused
TIM8 trigger and commutation interrupts | | unused
TIM8 capture compare interrupt | | unused
FPU global interrupt | | unused
FDCAN2 interrupt 0 | | unused
FDCAN2 interrupt 1 | | unused
LPUART1 global interrupt | | unused
4.3.2. NVIC Code generation

Enabled interrupt Table Select for init
sequence ordering
| | Generate IRQ
| | handler | Call HAL handler

Enabled interrupt Table | Select for init sequence ordering | Generate IRQ handler | Call HAL handler
Non maskable interrupt | false | true | false
Hard fault interrupt | false | true | false
Memory management fault | false | true | false
Prefetch fault, memory access fault | false | true | false
Undefined instruction or illegal state | false | true | false
System service call via SWI instruction | false | true | false
Debug monitor | false | true | false
Pendable request for system service | false | true | false
System tick timer | false | true | true

* User modified value

## 5. System Views

5.1. Category view
5.1.1. Current

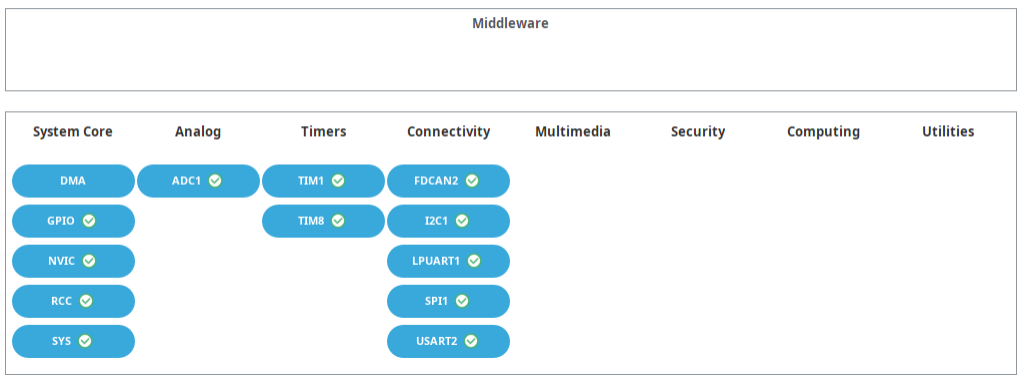
[picture p5: figure]

## 6. Docs & Resources

Type | Link
BSDL files | https://www.st.com/resource/en/bsdl_model/stm32g4_bsdl.zip
IBIS models | https://www.st.com/resource/en/ibis_model/stm32g4_ibis.zip
System View Description | https://www.st.com/resource/en/svd/stm32g4_svd.zip
Presentations | https://www.st.com/resource/en/product_presentation/stm32-stm8_embedded_software_solutions.pdf
Presentations | https://www.st.com/resource/en/product_presentation/stm32_eval-tools_portfolio.pdf
Presentations | https://www.st.com/resource/en/product_presentation/stm32_stm8_functi onal-safety-packages.pdf
Presentations | https://www.st.com/resource/en/product_presentation/stm32-usb-c-pd-solutions-presentation.pdf
Presentations | https://www.st.com/resource/en/product_presentation/stm32-stm8_software_development_tools.pdf
Presentations | https://www.st.com/resource/en/product_presentation/microcontrollers-stm32-family-overview.pdf
Presentations | https://www.st.com/resource/en/product_presentation/microcontrollers-stm32g4-series-product-overview.pdf
Brochures | https://www.st.com/resource/en/brochure/products-and-solutions-for-plcs-and-smart-i-os.pdf
Flyers | https://www.st.com/resource/en/flyer/flstm32g4.pdf
Flyers | https://www.st.com/resource/en/flyer/flstm32nucleo.pdf
Flyers | https://www.st.com/resource/en/flyer/flstm32trust.pdf
Flyers | https://www.st.com/resource/en/flyer/fldpstpfc11120.pdf
Security Bulletin | https://www.st.com/resource/en/technical_note/tn1489-security-bulletin-tn1489stpsirt-physical-attacks-on-stm32-and-stm32cube-firmware-stmicroelectronics.pdf
Application Notes | https://www.st.com/resource/en/application_note/an1709-emc-design-guide-for-stm8-stm32-and-legacy-mcus-stmicroelectronics.pdf

Application Notes | https://www.st.com/resource/en/application_note/an2606-stm32-microcontroller-system-memory-boot-mode-stmicroelectronics.pdf
Application Notes | https://www.st.com/resource/en/application_note/an3126-audio-and-waveform-generation-using-the-dac-in-stm32-products-stmicroelectronics.pdf
Application Notes | https://www.st.com/resource/en/application_note/an3155-usart-protocol-used-in-the-stm32-bootloader-stmicroelectronics.pdf
Application Notes | https://www.st.com/resource/en/application_note/an3156-usb-dfu-protocol-used-in-the-stm32-bootloader-stmicroelectronics.pdf
Application Notes | https://www.st.com/resource/en/application_note/an4221-i2c-protocol-used-in-the-stm32-bootloader-stmicroelectronics.pdf
Application Notes | https://www.st.com/resource/en/application_note/an4232-getting-started-with-analog-comparators-for-stm32f3-series-and-stm32g4-series-devices-stmicroelectronics.pdf
Application Notes | https://www.st.com/resource/en/application_note/an4286-spi-protocol-used-in-the-stm32-bootloader-stmicroelectronics.pdf
Application Notes | https://www.st.com/resource/en/application_note/an4296-use-stm32f3stm32g4-ccm-sram-with-iar-embedded-workbench-keil-mdkarm-stmicroelectronics-stm32cubeide-and-other-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
Application Notes | https://www.st.com/resource/en/application_note/an4655-virtually-increasing-the-number-of-serial-communication-peripherals-in-stm32-applications-stmicroelectronics.p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
Application Notes | https://www.st.com/resource/en/application_note/an4750-handling-of-soft-errors-in-stm32-applications-stmicroelectronics.pdf
Application Notes | https://www.st.com/resource/en/application_note/an4776-generalpurpose-timer-cookbook-for-stm32-microcontrollers-stmicroelectronics.pdf
Application Notes | https://www.st.com/resource/en/application_note/an4803-highspeed-si-simulations-using-ibis-and-boardlevel-simulations-using-hyperlynx-si-on-stm32-mcus-and-mpus-stmic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
Application Notes | https://www.st.com/resource/en/application_note/an4989-stm32-microcontroller-debug-toolbox-stmicroelectronics.pdf
Application Notes | https://www.st.com/resource/en/application_note/an5027-interfacing-pdm-

| digital-microphones-using-stm32-mcus-and-mpus-stmicroelectronics.pdf
Application Notes | https://www.st.com/resource/en/application_note/an5093-getting-started-with-stm32g4-series--hardware-development-boards-stmicroelectronics.pdf
Application Notes | https://www.st.com/resource/en/application_note/an5306-operational-amplifier-opamp-usage-in-stm32g4-series-stmicroelectronics.pdf
Application Notes | https://www.st.com/resource/en/application_note/an5310-guideline-for-using-analog-features-of-stm32g4-series-versus-stm32f3-series-devices-stmicroelectronics.pdf
Application Notes | https://www.st.com/resource/en/application_note/an5315-stm32cube-firmware-examples-for-stm32g4-series-stmicroelectronics.pdf
Application Notes | https://www.st.com/resource/en/application_note/an5346-stm32g4-adc-use-tips-and-recommendations-stmicroelectronics.pdf
Application Notes | https://www.st.com/resource/en/application_note/an5094-migrating-between-stm32f334303-lines-and-stm32g431xxg474xxg491xx-microcontrollers-stmicroelectronics.pdf
Application Notes | https://www.st.com/resource/en/application_note/an5738-stm32g4-series-lifetime-estimates-stmicroelectronics.pdf
Application Notes | https://www.st.com/resource/en/application_note/an4760-quadspi-interface-on-stm32-microcontrollers-and-microprocessors--stmicroelectronics.pdf
Application Notes | https://www.st.com/resource/en/application_note/an4899-stm32-microcontroller-gpio-hardware-settings-and-lowpower-consumption-stmicroelectronics.pdf
Application Notes | https://www.st.com/resource/en/application_note/an5612-esd-protection-of-stm32-mcus-and-mpus-stmicroelectronics.pdf
Application Notes | https://www.st.com/resource/en/application_note/an4991-how-to-wake-up-an-stm32-microcontroller-from-lowpower-mode-with-the-usart-or-the-lpuart-stmicroelectronics.pdf
Application Notes | https://www.st.com/resource/en/application_note/an4838-introduction-to-memory-protection-unit-management-on-stm32-mcus-stmicroelectronics.pdf
Application Notes | https://www.st.com/resource/en/application_note/an5325-how-to-use-the-

| cordic-to-perform-mathematical-functions-on-stm32-mcus-stmicroelectronics.pdf
Application Notes | https://www.st.com/resource/en/application_note/an5225-introduction-to-usb-typec-power-delivery-for-stm32-mcus-and-mpus-stmicroelectronics.pdf
Application Notes | https://www.st.com/resource/en/application_note/an4894-how-to-use-eeprom-emulation-on-stm32-mcus-stmicroelectronics.pdf
Application Notes | https://www.st.com/resource/en/application_note/an5537-how-to-use-adc-oversampling-techniques-to-improve-signaltonoise-ratio-on-stm32-mcus-stmicroelectronics.pdf
Application Notes | https://www.st.com/resource/en/application_note/an5036-guidelines-for-thermal-management-on-stm32-applications-stmicroelectronics.pdf
Application Notes | https://www.st.com/resource/en/application_note/an5405-how-to-use-fdcan-bootloader-protocol-on-stm32-mcus-stmicroelectronics.pdf
Application Notes | https://www.st.com/resource/en/application_note/an5978-introduction-to-mb1971-llc-hat-12-v-to-75-v1-a-for-f334-g474-nucleo-board-stmicroelectronics.pdf
Application Notes | https://www.st.com/resource/en/application_note/an5690-how-to-use-vrefbuf-peripheral-on-stm32-mcus-and-mpus-stmicroelectronics.pdf
Application Notes | https://www.st.com/resource/en/application_note/an4230-introduction-to-random-number-generation-validation-using-the-nist-statistical-test-suite-for-stm32-mcus-and-m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
Application Notes | https://www.st.com/resource/en/application_note/an2548-introduction-to-dma-controller-for-stm32-mcus-stmicroelectronics.pdf
Application Notes | https://www.st.com/resource/en/application_note/an4013-introduction-to-timers-for-stm32-mcus-stmicroelectronics.pdf
Application Notes | https://www.st.com/resource/en/application_note/an4277-how-to-use-pwm-shutdown-for-motor-control-and-digital-power-conversion-on-stm32-mcus-stmicroelectronics.pdf
Application Notes | https://www.st.com/resource/en/application_note/an4635-how-to-optimize-lpuart-power-consumption-on-stm32-mcus-stmicroelectronics.pdf
Application Notes | https://www.st.com/resource/en/application_note/an4759-introduction-to-

| using-the-hardware-realtime-clock-rtc-and-the-tamper-management-unit-tamp-with-stm32-mcus-stmicroelectronics.pdf
Application Notes | https://www.st.com/resource/en/application_note/an4908-getting-started-with-usart-automatic-baud-rater-detection-for-stm32-mcus-stmicroelectronics.pdf
Application Notes | https://www.st.com/resource/en/application_note/an5156-introduction-to-security-for-stm32-mcus-stmicroelectronics.pdf
Application Notes | https://www.st.com/resource/en/application_note/an5224-introduction-to-dmamux-for-stm32-mcus-stmicroelectronics.pdf
Application Notes | https://www.st.com/resource/en/application_note/an5543-guidelines-for-enhanced-spi-communication-on-stm32-mcus-and-mpus-stmicroelectronics.pdf
Application Notes | https://www.st.com/resource/en/application_note/an5348-introduction-to-fdcan-peripherals-for-stm32-mcus-stmicroelectronics.pdf
Application Notes | https://www.st.com/resource/en/application_note/cd00211314-how-to-optimize-the-adc-accuracy-in-the-stm32-mcus-stmicroelectronics.pdf
Application Notes | https://www.st.com/resource/en/application_note/an2639-soldering-recommendations-and-package-information-for-leadfree-ecopack2-mcus-and-mpus-stmicroelectronics.pdf
Application Notes | https://www.st.com/resource/en/application_note/an4566-how-to-extend-the-dac-performance-on-stm32-mcus-stmicroelectronics.pdf
Application Notes for related Tools & Software | https://www.st.com/resource/en/application_note/an4435-guidelines-for-obtaining-ulcsaiec-607301603351-class-b-certification-in-any-stm32-application-stmicroelectroni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
Application Notes for related Tools & Software | https://www.st.com/resource/en/application_note/an4657-stm32-inapplication-programming-iap-using-the-usart-stmicroelectronics.pdf
Application Notes for related Tools & Software | https://www.st.com/resource/en/application_note/an4841-digital-signal-processing-for-stm32-microcontrollers-using-cmsis-stmicroelectronics.pdf
Application Notes for related Tools & Software | https://www.st.com/resource/en/application_note/an5056-integration-guide-for-the-xcubesbsfu-stm32cube-expansion-package-stmicroelectronics.pdf

Application Notes for related Tools & Software | https://www.st.com/resource/en/application_note/an5305-digital-filter-implementation-with-the-fmac-using-stm32cubeg4-mcu-package-stmicroelectronics.pdf
Application Notes for related Tools & Software | https://www.st.com/resource/en/application_note/an5315-stm32cube-firmware-examples-for-stm32g4-series-stmicroelectronics.pdf
Application Notes for related Tools & Software | https://www.st.com/resource/en/application_note/an5345-highbrightness-rgb-led-control-using-the-bg474edpow1-discovery-kit-stmicroelectronics.pdf
Application Notes for related Tools & Software | https://www.st.com/resource/en/application_note/an5360-getting-started-with-projects-based-on-the-stm32mp1-series-in-stm32cubeide-stmicroelectronics.pdf
Application Notes for related Tools & Software | https://www.st.com/resource/en/application_note/an5361-getting-started-with-projects-based-on-dualcore-stm32h7-microcontrollers-in-stm32cubeide-stmicroelectronics.pd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
Application Notes for related Tools & Software | https://www.st.com/resource/en/application_note/an5394-getting-started-with-projects-based-on-the-stm32l5-series-in-stm32cubeide-stmicroelectronics.pdf
Application Notes for related Tools & Software | https://www.st.com/resource/en/application_note/an5418-how-to-build-a-simple-usbpd-sink-application-with-stm32cubemx-stmicroelectronics.pdf
Application Notes for related Tools & Software | https://www.st.com/resource/en/application_note/an5426-migrating-graphics-middleware-projects-from-stm32cubemx-540-to-stm32cubemx-550-stmicroelectronics.pdf
Application Notes for related Tools & Software | https://www.st.com/resource/en/application_note/an5464-position-control-of-a-threephase-permanent-magnet-motor-using-xcubemcsdk-or-xcubemcsdkful-stmicroelectronics.p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
Application Notes for related Tools & Software | https://www.st.com/resource/en/application_note/an5564-getting-started-with-projects-based-on-dualcore-stm32wl-microcontrollers-in-stm32cubeide-stmicroelectronics.pd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
Application Notes for related Tools & Software | https://www.st.com/resource/en/application_note/an5698-adapting-the-xcubestl-functional-safety-package-for-stm32-iec-61508-compliant-to-other-safety-standards-stmicr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
Application Notes | https://www.st.com/resource/en/application_note/an5731-stm32cubemx-

for related Tools & Software | and-stm32cubeide-threadsafe-solution-stmicroelectronics.pdf
Application Notes for related Tools & Software | https://www.st.com/resource/en/application_note/an5785-boost-voltage-mode-on-bg474edpow1-discovery-kit-stmicroelectronics.pdf
Application Notes for related Tools & Software | https://www.st.com/resource/en/application_note/an5788-stm32-digital-power-pid-and-iir-filters-for-smps-control-design-and-comparison-on-bg414edpow1-discovery-kit-st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
Application Notes for related Tools & Software | https://www.st.com/resource/en/application_note/an4502-stm32-smbuspmbus-expansion-package-for-stm32cube-stmicroelectronics.pdf
Application Notes for related Tools & Software | https://www.st.com/resource/en/application_note/an5952-how-to-use-cmake-in-stm32cubeide-stmicroelectronics.pdf
Application Notes for related Tools & Software | https://www.st.com/resource/en/application_note/an4635-how-to-optimize-lpuart-power-consumption-on-stm32-mcus-stmicroelectronics.pdf
Application Notes for related Tools & Software | https://www.st.com/resource/en/application_note/an5054-how-to-perform-secure-programming-using-stm32cubeprogrammer-stmicroelectronics.pdf
Application Notes for related Tools & Software | https://www.st.com/resource/en/application_note/an5496-guidelines-for-the-buck-voltage-mode-on-the-bg474edpow1-discovery-kit-stmicroelectronics.pdf
Application Notes for related Tools & Software | https://www.st.com/resource/en/application_note/an5497-introduction-to-the-buck-current-mode-with-the-bg474edpow1-discovery-kit-stmicroelectronics.pdf
Application Notes for related Tools & Software | https://www.st.com/resource/en/application_note/an6179-how-to-integrate-the-stl-firmware-into-a-time-critical-user-application-stmicroelectronics.pdf
Application Notes for related Tools & Software | https://www.st.com/resource/en/application_note/an6127-getting-started-with-stm32h7rx7sx-mcus-in-stm32cubeide-stmicroelectronics.pdf
Errata Sheets | https://www.st.com/resource/en/errata_sheet/es0523-stm32g491xx4a1xx-device-errata-stmicroelectronics.pdf

Datasheet | https://www.st.com/resource/en/datasheet/dm00654712.pdf
Programming Manuals | https://www.st.com/resource/en/programming_manual/pm0214-stm32-cortexm4-mcus-and-mpus-programming-manual-stmicroelectronics.pdf
Reference Manuals | https://www.st.com/resource/en/reference_manual/rm0440-stm32g4-series-advanced-armbased-32bit-mcus-stmicroelectronics.pdf
Technical Notes & Articles | https://www.st.com/resource/en/technical_note/tn1163-description-of-wlcsp-for-microcontrollers-and-recommendations-for-its-use-stmicroelectronics.pdf
Technical Notes & Articles | https://www.st.com/resource/en/technical_note/tn1204-tape-and-reel-shipping-media-for-stm32-microcontrollers-in-bga-packages-stmicroelectronics.pdf
Technical Notes & Articles | https://www.st.com/resource/en/technical_note/tn1205-tape-and-reel-shipping-media-for-stm8-and-stm32-microcontrollers-in-fpn-packages-stmicroelectronics.pdf
Technical Notes & Articles | https://www.st.com/resource/en/technical_note/tn1206-tape-and-reel-shipping-media-for-stm8-and-stm32-microcontrollers-in-qfp-packages-stmicroelectronics.pdf
Technical Notes & Articles | https://www.st.com/resource/en/technical_note/tn1207-tape-and-reel-shipping-media-for-stm8-and-stm32-microcontrollers-in-so-packages-stmicroelectronics.pdf
Technical Notes & Articles | https://www.st.com/resource/en/technical_note/tn1208-tape-and-reel-shipping-media-for-stm8-and-stm32-microcontrollers-in-tssop-and-ssop-packages-stmicroelectronics.p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
Technical Notes & Articles | https://www.st.com/resource/en/technical_note/tn1433-reference-device-marking-schematics-for-stm32-microcontrollers-and-microprocessors-stmicroelectronics.pdf
User Manuals | https://www.st.com/resource/en/user_manual/um3167-stm32g4-series-ulcsaiec-607301603351-selftest-library-user-guide-stmicroelectronics.pdf
