alex31/paparazzi_minican/docs/index.md

# MicroCAN Documentation

This is the entry point for project documentation. The docs are split into
software and hardware sections.

Software
- [software/overview.md](software/overview.md)
- [software/architecture.md](software/architecture.md)
- [software/build_flash.md](software/build_flash.md)
- [software/roles/overview.md](software/roles/overview.md)
- [software/parameters.md](software/parameters.md)
- [software/compilation_toggles.md](software/compilation_toggles.md)
- [software/hardware_resources.md](software/hardware_resources.md)
- [software/adding_roles.md](software/adding_roles.md)
- [software/onboard_rgb_led.md](software/onboard_rgb_led.md)

Hardware
- [hardware/overview.md](hardware/overview.md)
- [hardware/bringup.md](hardware/bringup.md)
- [hardware/boards/microcan_v5.md](hardware/boards/microcan_v5.md)

Assets (images, diagrams)
- [assets/](assets/)
