alex31/paparazzi_minican/tools/test400.txt

#include "roleConf.h"

#if USE_SERIAL_STREAM_ROLE

#include "serialStreamRole.hpp"
#include "hardwareConf.hpp"
#include "ressourceManager.hpp"
#include "stdutil++.hpp"
#include <new>
#include <type_traits>

/*
  Todo:

  declarer 2 fifoobject :
  dans le sens uart -> uavcan object = std::array<uint8_t, 300> et il y en a 5
  dans le s
