alex31/paparazzi_minican/docs/hardware/bringup.md

# Bringup

This file collects bringup notes and checklists for new boards. Add your
team-specific steps here.

For flashing and build commands, see:
- [docs/software/build_flash.md](../software/build_flash.md)
