alex31/paparazzi_minican/tools/test200.txt

#include "roleConf.h"

#if USE_SERIAL_STREAM_ROLE

#include <algorithm>
#include <new>
#include <cstring>

#include "serialStreamRole.hpp"
#include "hardwareConf.hpp"
#include "ressourceManager.hpp
