alex31/paparazzi_minican/tools/test50.txt

#include "roleConf.h"

#if USE_SERIAL_STREAM_RO
