alex31/paparazzi_minican/TODO.txt

CODÉ MAIS PAS TESTÉ :

  ° tester roleUbxGps en mode configuration

  °  Tester : le specific code application pour remonter des infos :
    - code si il y a des pb d'alim ou autre
    - tester si on boote après un watchdog reset en provoquant un panic avec la commande panic du shell
---

A DEBUGGER:

---

DOXYGEN :
  -> reprendre la doc de tous les fichiers
---

GITHUB :
° projet autonome avec sous-modules pour chibios, COMMON, DSDL, ETL, frozen, etc
° binaire de gcc15.2 pour ubuntu telechargeable en binaire
---

 Rédiger une DOCUMENTATION
   -> description globale du projet
   -> description du hardware
   -> howto: build
   -> description des roles existants
      ° enable disable des roles via les paramètres
      ° enable disable des roles à la compilation
      ° manuel d'utilisation des roles existants : configuration branchements
   -> description de l'architecture
   -> howto: ajouter un role
      ° ajouter un role avec un LLM
---

ROLES à améliorer :
TUNNEL SERIAL :
  -> version qui gere la comm/config xbee et qui decapsule encapsule le header xbee ?

ROLES à ajouter :
  ° role IO_expender
  ° IMU avec notch filtering
  ° full AHRS ?
  ° motor stepper ?

AHRS / notch filtering notes:
  - ArduPilot applies harmonic notch filters in software (biquad on CPU).
  - FFT is only used to estimate notch center frequencies; the filter itself is still biquad.
  - Invensense IMU driver configures AAF/LPF; internal IMU notch is left at default.
  - ArduPilot uses CMSIS-DSP mainly for FFT (GyroFFT), not for notch filters.
  - CMSIS-DSP in ArduPilot is shipped as prebuilt DSP libs + headers.
  - Microcan plan (recent Invensense 6-axis IMU):
    * Use gyro notch from bidir DShot RPM (4 motors + harmonics).
    * Update notch coefficients at low rate (e.g., 50-200 Hz).
    * Optional FFT-based tracking for non-motor resonances if CPU budget allows.
    * Keep IMU AAF/LPF enabled as the first stage.

  Core Sensor Roles

  - Airspeed sensor publishing uavcan.equipment.air_data.RawAirData — Tools/AP_Periph/airspeed.cpp
  - Rangefinder + proximity publishing uavcan.equipment.range_sensor.Measurement / proximity grids
  — Tools/AP_Periph/rangefinder.cpp and Tools/AP_Periph/proximity.cpp
  - IMU (accel/gyro) publishing uavcan.equipment.ahrs.* — Tools/AP_Periph/imu.cpp
  - Battery monitor + BMS/cell telemetry — Tools/AP_Periph/battery.cpp, Tools/AP_Periph/battery_bms.cpp,
    Tools/AP_Periph/battery_tag.cpp, Tools/AP_Periph/batt_balance.cpp
  - RPM sensor telemetry — Tools/AP_Periph/rpm.cpp
  - Temperature sensor telemetry — Tools/AP_Periph/temperature.cpp

  Optional/Specialized Roles

  - GNSS extras: RTCM stream pass‑through + moving‑baseline/heading — Tools/AP_Periph/gps.cpp
  - Relay/Hardpoint outputs — Tools/AP_Periph/relay.cpp and Tools/AP_Periph/hardpoint.cpp
  - Buzzer/notify output — Tools/AP_Periph/buzzer.cpp

---

IO-EXPENDER : suggestion ->
- pprz.gpio.Configure (broadcast):
      - Pin[<=N] pins
      - Pin:
          - uint8 index       # absolute pin index
          - uint8 mode        # 0=in, 1=out
          - uint8 pull        # 0=float, 1=pullup, 2=pulldown
          - uint8 drive       # 0=push-pull, 1=open-drain
          - uint8 slewrate    # 0=low, 1=high
          - uint8 value       # optional initial output state (for outputs)
  - pprz.gpio.SetValue (broadcast):
      - Value[<=N] pins
      - Value: uint8 index, uint8 value
  - pprz.gpio.SetPolling (broadcast):
      - Poll[<=N] pins
      - Poll: uint8 index, uint8 enable (1 = poll)
      - uint16 period_ms (common period for this message)
  - pprz.gpio.State (broadcast):
      - State[<=N] pins
      - State: uint8 index, uint8 mode, uint8 pull, uint8 drive, uint8 slewrate, uint8 value, optional uint8 fault
---

Problematique sur FDCanV1 (G4) :
fifo hardware profondeur 3 : 3x64 en fdcan mais seulement 3x8 en CAN 2.0

---

====

CODE MODERNIZATION (C++26 / GCC 15.2):

  ° DeviceStatus Monadic Flow:
    + add DeviceStatus::and_then(F&& f) to allow chaining role initialization.
    + flatten UAVCanSlave.cpp::start() by replacing the pyramid of 'if(ok)' with a monadic pipeline.

  ° Flash Optimization (Remove snprintf):
    + replace snprintf calls with std::to_chars (constexpr in C++26) for numeric conversions.
    + objective: remove the expensive printf/formatting engine from the binary (gain ~5-10KB).

  ° String Handling (Modern std::string_view):
    + replace manual size checks and strncmp with C++23 methods: starts_with(), ends_with(), contains().
    + impact: cleaner code, better compiler optimization, zero RAM overhead.

  ° Template Simplification (Structural Types):
    + replace FixedString wrapper in addRole<...>() with C++20 StringLiteral structural type.
    + allows passing "ROLE.name" directly as a template parameter.

  ° Variant/Visitor Modernization:
    + use a variadic 'overload' lambda helper for variant/StoredValue visiting in ttyConsole.cpp.
    + removes the need for separate visitor structs (OverloadDyn).

  ° DSDL Static Assignment:
    + use consteval helpers for assigning literal strings to DSDL fields (text.len + text.data).
    + ensures length validation at compile-time and optimized register-to-memory transfers.

  ° Chrono Integration (Glue for ChibiOS):
    + implement a chibios_clock for std::chrono integration.
    + allows using 300ms, 1s literals safely while mapping to chibios ticks (sysinterval_t).
