alex31/paparazzi_minican/HARDWARE/MICROCAN/MicroCan_v5_schematic.pdf

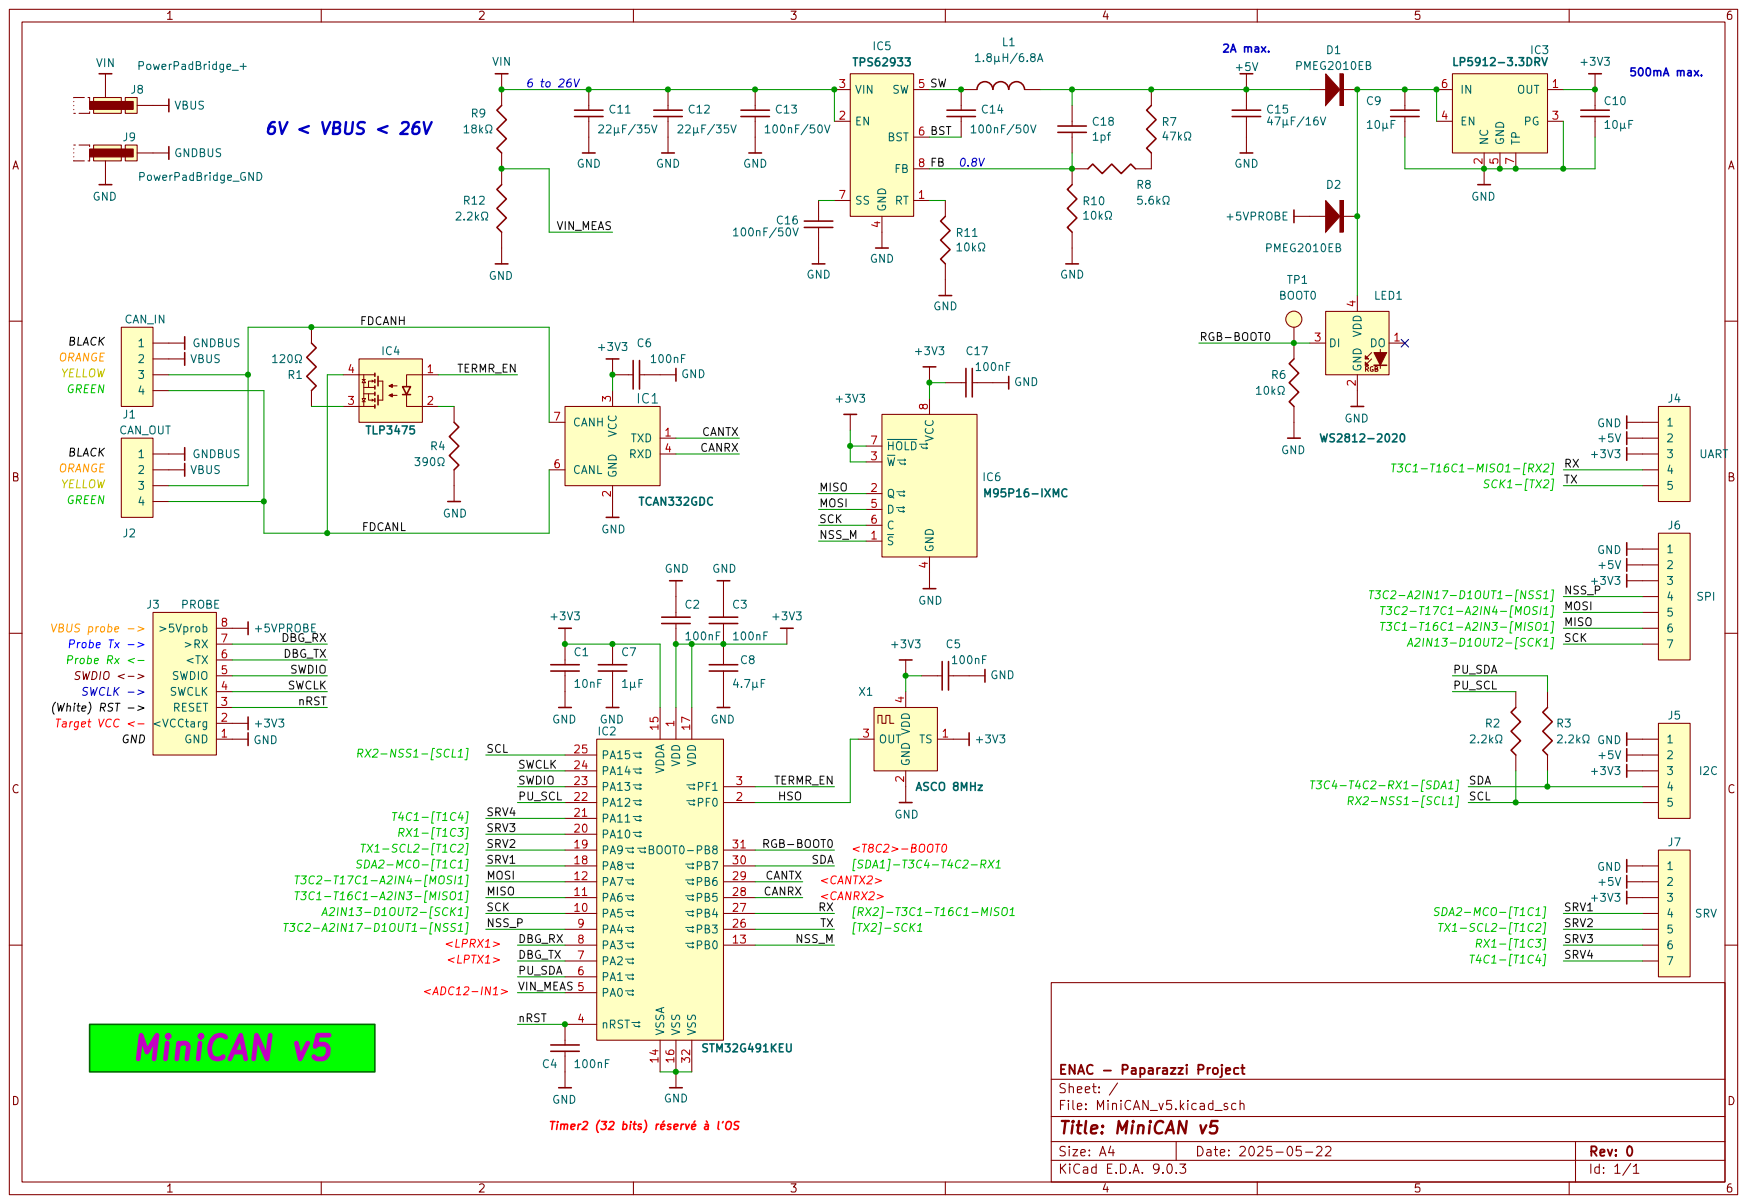
[picture p6: page 1]
