alex31/paparazzi_minican/HARDWARE/MICROCAN/MicroCAN_v5.ioc

Mcu.UserName=STM32G491KEUx
PA0.GPIO_Label=VIN_MEAS (ADC1_IN1)
PA0.Signal=ADC1_IN1
PA1.GPIO_Label=PU_SDA (GPIO Out)
PA1.Signal=GPIO_Output
PA10.GPIO_Label=SRV3 (T1C3)
PA10.Signal=S_TIM1_CH3
PA11.GPIO_Label=SRV4 (T1C4)
PA11.Signal=S_TIM1_CH4
PA12.GPIO_Label=PU_SCL (GPIO Out)
PA12.Signal=GPIO_Output
PA13.GPIO_Label=SWDIO
PA13.Signal=SYS_JTMS-SWDIO
PA14.GPIO_Label=SWCLK
PA14.Signal=SYS_JTCK-SWCLK
PA15.GPIO_Label=SCL (SCL1)
PA15.Signal=I2C1_SCL
PA2.GPIO_Label=DBG_TX (LPTX1)
PA2.Signal=LPUART1_TX
PA3.GPIO_Label=DBG_RX (LPRX1)
PA3.Signal=LPUART1_RX
PA4.GPIO_Label=NSS_P (NSS1)
PA4.Signal=SPI1_NSS
PA5.GPIO_Label=SCK (SCK1)
PA5.Signal=SPI1_SCK
PA6.GPIO_Label=MISO (MISO1)
PA6.Signal=SPI1_MISO
PA7.GPIO_Label=MOSI (MOSI1)
PA7.Signal=SPI1_MOSI
PA8.GPIO_Label=SRV1 (T1C1)
PA8.Signal=S_TIM1_CH1
PA9.GPIO_Label=SRV2 (T1C2)
PA9.Signal=S_TIM1_CH2
PB0.GPIO_Label=NSS_M (GPIO Out)
PB0.Signal=GPIO_Output
PB3.GPIO_Label=TX (TX2)
PB3.Signal=USART2_TX
PB4.GPIO_Label=RX (RX2)
PB4.Signal=USART2_RX
PB5.GPIO_Label=CANRX (FDCANRX2)
PB5.Signal=FDCAN2_RX
PB6.GPIO_Label=CANTX (FDCANTX2)
PB6.Signal=FDCAN2_TX
PB7.GPIO_Label=SDA (SDA1)
PB7.Signal=I2C1_SDA
PB8-BOOT0.GPIO_Label=RGB-BOOT0 (T8C2)
PB8-BOOT0.Signal=S_TIM8_CH2
PF0-OSC_IN.GPIO_Label=HSO
PF0-OSC_IN.Signal=RCC_OSC_IN
PF1-OSC_OUT.GPIO_Label=TERMR_EN (GPIO Out)
PF1-OSC_OUT.Signal=GPIO_Output
PG10-NRST.GPIO_Label=nRST
PG10-NRST.Signal=GPIO_Input
