alex31/paparazzi_minican/COMMON/source/hardwareConf.hpp

/**
 * @file hardwareConf.hpp
 * @brief Hardware configuration constants and aliases.
 */
#pragma once
#include "hal.h"
#include "UAVCAN/persistantStorage.hpp"


/*
#                 ______   _____         
#                /  ____| |_   _|        
#                | (___     | |          
#                 \___ \    | |          
#                .____) |  _| |_         
#                \_____/  |_____|        
#                                                              _      _                   
#                                                             | |    (_)                  
#                  ___    ___    _ __   __   __   ___   _ __  | |_    _     ___    _ __   
#                 / __|  / _ \  | '_ \  \ \ / /  / _ \ | '__| | __|  | |   / _ \  | '_ \  
#                | (__  | (_) | | | | |  \ V /  |  __/ | |    \ |_   | |  | (_) | | | | | 
#                 \___|  \___/  |_| |_|   \_/    \___| |_|     \__|  |_|   \___/  |_| |_| 
*/

#define CONCAT_NX(st1, st2) st1 ## st2
#define CONCAT3_NX(st1, st2, st3) st1 ## st2 ## st3
#define CONCAT(st1, st2) CONCAT_NX(st1, st2)
#define CONCAT3(st1, st2, st3) CONCAT3_NX(st1, st2, st3)

#define STR_(x) #x
#define STR(x)  STR_(x)
#define NAME_STRING(prefix, sep, version) prefix sep version
#define DEVICE_NAME NAME_STRING("org.pprz.microcan", "V", STR(HW_VERSION))
using namespace std::literals;

static constexpr uint32_t operator""_hz (unsigned long long int freq)
{
  return freq;
}
/** @brief Frequency literal in kHz. */
static constexpr uint32_t operator""_khz (unsigned long long int freq)
{
  return freq * 1000UL;
}
/** @brief Frequency literal in MHz. */
static constexpr uint32_t operator""_mhz (unsigned long long int freq)
{
  return freq * 1000_khz;
}
/** @brief Resistance literal in ohms. */
static constexpr long double operator""_ohm (long double resistance)
{
  return resistance;
}
/** @brief Resistance literal in kilo-ohms. */
static constexpr long double operator""_kohm (long double resistance)
{
  return resistance * 1000UL;
}
/** @brief Percentage literal as an integer scaled by 100. */
static constexpr uint32_t operator""_percent (unsigned long long int freq)
{
  return freq * 100UL;
}

/*
#                 _                          _                                           
#                | |                        | |                                          
#                | |__     __ _   _ __    __| |  __      __   __ _   _ __    ___         
#                | '_ \   / _` | | '__|  / _` |  \ \ /\ / /  / _` | | '__|  / _ \        
#                | | | | | (_| | | |    | (_| |   \ V  V /  | (_| | | |    |  __/        
#                |_| |_|  \__,_| |_|     \__,_|    \_/\_/    \__,_| |_|     \___|        
#                                               _                     _            _            
#                                              | |                   (_)          | |           
#                  ___    ___    _ __    ___   | |_    _ __    __ _   _    _ __   | |_          
#                 / __|  / _ \  | '_ \  / __|  | __|  | '__|  / _` | | |  | '_ \  | __|         
#                | (__  | (_) | | | | | \__ \  \ |_   | |    | (_| | | |  | | | | \ |_          
#                 \___|  \___/  |_| |_| |___/   \__|  |_|     \__,_| |_|  |_| |_|  \__|         
*/
#ifdef M95P_RAM_EMULATION
constexpr size_t SECTOR_SIZE_BYTES = 512U;
constexpr size_t MFS_BANK_SIZE_BYTES = (64U * 1024U);
constexpr size_t BLANK_GAP_SIZE_SECTORS = 0U;
#else
constexpr size_t SECTOR_SIZE_BYTES = 512U;
constexpr size_t MFS_BANK_SIZE_BYTES = (256U * 1024U);
constexpr size_t BLANK_GAP_SIZE_SECTORS = ((128U * 1024U) / SECTOR_SIZE_BYTES);
#endif

static constexpr SPIDriver& EepromSPID	  = SPID1;

#if defined(PLATFORM_MICROCAN) && PLATFORM_MICROCAN
static constexpr SPIDriver& ExternalSPID  = SPID1;
static constexpr I2CDriver& ExternalI2CD  = I2CD1;
#define EXTERNAL_USART_ID UART_TX_USART
#if HAL_USE_UART
static constexpr UARTDriver &ExternalUARTD = CONCAT(UARTD, UART_TX_USART);
#endif
#if HAL_USE_SIO
static constexpr SIODriver &ExternalSIOD = SIOD2;
#endif
// External WS2812 strip on PB07 (TIM3_CH4)
#define LED2812_TIM      I2C_SDA_TIM
#define LED2812_TIM_CH   I2C_SDA_TIM_CH
static constexpr PWMDriver& LedStripPWMD  = CONCAT(PWMD, LED2812_TIM);
#elif (!defined BOOTLOADER_MCAN)
#error PLATFORM_MICROCAN and/or BOOTLOADER_MCAN not defined
#endif

#if defined(EXTERNAL_USART_ID)
#define EXTERNAL_USART_RX_DMAMUX CONCAT3(STM32_DMAMUX1_USART, EXTERNAL_USART_ID, _RX)
#define EXTERNAL_USART_TX_DMAMUX CONCAT3(STM32_DMAMUX1_USART, EXTERNAL_USART_ID, _TX)
#endif

/** @brief SPI configuration for the EEPROM device. */
static inline const SPIConfig eepromSpiCfg = {
    .circular       = false,
    .slave          = false,
    .data_cb        = nullptr,
    .error_cb       = nullptr,
    .ssline         = LINE_SPI_EEPROM_CS,
    .cr1            = SPI_CR1_BR_0, // 42Mhz
    .cr2            = SPI_CR2_DS_2 | SPI_CR2_DS_1 | SPI_CR2_DS_0
};  

/*
#                                                    
#                                                    
#                 _   _   ___     ___   _ __         
#                | | | | / __|   / _ \ | '__|        
#                | |_| | \__ \  |  __/ | |           
#                 \__,_| |___/   \___| |_|           
#                            _    _    _              _       _                 
#                           | |  (_)  | |            | |     | |                
#                  ___    __| |   _   | |_     __ _  | |__   | |    ___         
#                 / _ \  / _` |  | |  | __|   / _` | | '_ \  | |   / _ \        
#                |  __/ | (_| |  | |  \ |_   | (_| | | |_) | | |  |  __/        
#                 \___|  \__,_|  |_|   \__|   \__,_| |_.__/  |_|   \___|        
*/
static constexpr int maxCoreTemp = 60;
static constexpr float psBatMin = 6.5;
static constexpr float psBatMax = 25.2;
static constexpr float ps3vMax = 3.5;
static constexpr float ps3vMin = 3.0;
static constexpr float coreTempMin = -20.0f;
static constexpr float coreTempMax = 60.0f;
