alex31/paparazzi_minican/microcan/source/ttyConsole.cpp

/**
 * @file ttyConsole.cpp
 * @brief Console command handlers and parameter utilities.
 */

#include "ttyConsole.hpp"
#include "microrl/microrlShell.h"
extern "C" {
#include "microrl/microrl.h"
}
#include "consolePrintf.hpp"
#include "hardwareConf.hpp"
#include "resourceManager.hpp"
#include "UAVCanSlave.hpp"
#include "deviceResource.hpp"
#include "adcSurvey.hpp"

using FixedString = etl::string<128>;
using Value = std::variant<struct uavcan_protocol_param_Empty, int64_t, float, bool, FixedString>;

/*
  commande storage : st
  st -> liste tous les storages
  st clef -> retourne la valeur en ram
  st clef valeur -> set la valeur en ram puis en eeprom

  std::string_view + ses helpers C++20+ :

  - starts_with(...) pour ^motif
  - ends_with(...) pour motif$
  - contains(...) (C++23) pour “n’importe où”

  Ça ne tire aucune lib regex ni allocation si tu manipules des string_view. Exemple compact :

  bool match(std::string_view s, std::string_view pat) {
    if (pat.starts_with('^'))   return s.starts_with(pat.substr(1));
    if (pat.ends_with('$'))     return s.ends_with(pat.substr(0, pat.size()-1));

    return s.contains(pat);
    To continue this session, run codex resume 019abb4b-1562-7e60-99f9-779736784d48
  }


 */
#ifdef TRACE
#ifdef CONSOLE_DEV_SD

/*===========================================================================*/
/* START OF EDITABLE SECTION                                           */
/*===========================================================================*/

// declaration des prototypes de fonction
// ces declarations sont necessaires pour remplir le tableau commands[] ci-dessous
using cmd_func_t =  void  (BaseSequentialStream *lchp, int argc,const char * const argv[]);
static cmd_func_t cmd_mem, cmd_uid, cmd_restart, cmd_param, cmd_uavparam, cmd_storage, cmd_can;
static cmd_func_t cmd_adc, cmd_panic, cmd_info;
#if CH_DBG_STATISTICS
static cmd_func_t cmd_threads;
#endif
namespace {
  /** @brief Parse a string into a UAVCAN parameter value variant. */
  Value parse_value(etl::string_view input);
  /** @brief Parse an optional integer from a string view. */
  std::optional<int> parse_value_int(etl::string_view input = {});
  /** @brief Append a numeric parameter value to the console string. */
  FixedString &  appendFixed(FixedString &str, const uavcan_protocol_param_NumericValue &val);
  /** @brief Append a parameter value to the console string. */
  FixedString &  appendFixed(FixedString &str, const uavcan_protocol_param_Value &val);
  /** @brief Append a C string to the console string. */
  FixedString &  appendFixed(FixedString &str, const char *val);
  /** @brief Append a GetSet response payload to the console string. */
  FixedString &  appendFixed(FixedString &str, const uavcan_protocol_param_GetSetResponse &val);
  /** @brief Append a raw byte buffer to the console string. */
  FixedString &  appendFixed(FixedString &str, const uint8_t *ptr, size_t len);

  template <typename U>
  requires requires(FixedString& lhs, const U& rhs) {
    appendFixed(lhs, rhs);
  }
  FixedString& operator<<(FixedString& lhs, const U& rhs) {
    return appendFixed(lhs, rhs);
  }
  
  /** @brief List stored parameters, optionally filtered by prefix. */
  void  cmd_storage_list(etl::string_view = {}); 
  /** @brief Display a stored parameter by key. */
  void  cmd_storage_display(const char* key);
  /** @brief Set a stored parameter by key and value strings. */
  void  cmd_storage_set(const char* key, const char* value);
  /** @brief Display a parameter using UAVCAN GetSet semantics. */
  void  cmd_uavcan_storage_display(etl::string_view key);
  /** @brief Set a parameter using UAVCAN GetSet semantics. */
  void  cmd_uavcan_storage_set(etl::string_view key, etl::string_view value);
}



static const ShellCommand commands[] = {
  {"info", cmd_info},
  {"mem", cmd_mem},		// affiche la mémoire libre/occupée
#if  CH_DBG_STATISTICS
  {"threads", cmd_threads},	// affiche pour chaque thread le taux d'utilisation de la pile et du CPU
#endif
  {"uid", cmd_uid},		// affiche le numéro d'identification unique du MCU
  {"param", cmd_param},		// fonction à but pedagogique qui affiche les
				//   paramètres qui lui sont passés

  {"adc", cmd_adc},		// psBat readout + 2-point calibration (stores adc.psbat.scale/bias)

  {"st", cmd_storage},		// manage eeprom storage
  {"uavp", cmd_uavparam},	// manage parameters via UAVCan types
  {"can", cmd_can},		// print can speed, hardware/software version
  {"restart", cmd_restart},	// reboot MCU
  {"panic", cmd_panic},		// panic to force watchdog reset
 {NULL, NULL}			// marqueur de fin de tableau
};

namespace {
  struct AdcCalPoint { float voltage; float raw; };
  #define MAX_CPU_INFO_ENTRIES 20
  typedef struct _ThreadCpuInfo {
    float    ticks[MAX_CPU_INFO_ENTRIES];
    float    cpu[MAX_CPU_INFO_ENTRIES];
    float    totalTicks;
    float    totalISRTicks;
    _ThreadCpuInfo () {
      for (auto i=0; i< MAX_CPU_INFO_ENTRIES; i++) {
        ticks[i] = 0.0f;
        cpu[i] = -1.0f;
      }
      totalTicks = 0.0f;
      totalISRTicks = 0.0f;
    }
  } ThreadCpuInfo ;

  struct tty_console_cpu_window {
    rttime_t thread_time[MAX_CPU_INFO_ENTRIES];
    thread_t *thread_ref[MAX_CPU_INFO_ENTRIES];
    rttime_t prev_thread_time[MAX_CPU_INFO_ENTRIES];
    thread_t *prev_thread_ref[MAX_CPU_INFO_ENTRIES];
    uint32_t prev_thread_count;
    rttime_t prev_isr_time;
    uint8_t prev_stats_valid;
  };

  // Only a pointer is reserved here while the role is disabled. Buffers,
  // history and diagnostic samples are allocated together when it starts.
  struct ShellContext {
    microrl_t lineEditor{};
    const char *completions[std::size(commands)]{};
    std::optional<AdcCalPoint> adcCalFirstPoint;
#if CH_DBG_STATISTICS
    tty_console_cpu_window cpu_window{};
    ThreadCpuInfo threadCpuInfo;
#endif
  };
  ShellContext *shellContext = nullptr;
}

/*
  definition de la fonction cmd_param asociée à la commande param (cf. commands[])
  cette fonction a but pédagogique affiche juste les paramètres fournis, et tente
  de convertir les paramètres en entier et en flottant, et affiche le resultat de
  cette conversion. 
  une fois le programme chargé dans la carte, essayer de rentrer 
  param toto 10 10.5 0x10
  dans le terminal d'eclipse pour voir le résultat 
 */
/** @brief Console command: print and parse parameters. */
static void cmd_param(BaseSequentialStream *lchp, int argc,const char* const argv[])
{
  if (argc == 0) {  // si aucun paramètre n'a été passé à la commande param 
    chprintf(lchp, "pas de paramètre en entrée\r\n");
  } else { // sinon (un ou plusieurs pararamètres passés à la commande param 
    for (int argn=0; argn<argc; argn++) { // pour tous les paramètres
      chprintf(lchp, "le parametre %d/%d est %s\r\n", argn, argc-1, argv[argn]); // afficher

      // tentative pour voir si la chaine peut être convertie en nombre entier et en nombre flottant
      int entier = atoi (argv[argn]); // atoi converti si c'est possible une chaine en entier
      float flottant = atof (argv[argn]); // atof converti si c'est possible une chaine en flottant

      chprintf(lchp, "atoi(%s) = %d ;; atof(%s) = %.3f\r\n",
		argv[argn], entier, argv[argn], flottant);
    }
  }
}


/** @brief Console command: read/calibrate ADC battery voltage. */
static void cmd_adc(BaseSequentialStream *lchp, int argc, const char * const argv[])
{
  if (argc == 0) {
    const float raw = Adc::getPsBatRaw();
    const float corrected = Adc::getPsBat();
    chprintf(lchp, "adc: %.4f V (raw=%.4f V)\r\n", corrected, raw);
    return;
  }

  if (argc != 1) {
    chprintf(lchp, "usage: adc [known_voltage]\r\n");
    return;
  }

  const float voltage = atof(argv[0]);
  if (!(voltage > 0.0f)) {
    chprintf(lchp, "adc: invalid voltage '%s'\r\n", argv[0]);
    return;
  }

  const float raw = Adc::getPsBatRaw();

  if (!shellContext->adcCalFirstPoint.has_value()) {
    shellContext->adcCalFirstPoint = AdcCalPoint{voltage, raw};
    const float corrected = Adc::getPsBat();
    chprintf(lchp,
	     "adc: captured point V=%.3f raw=%.4f V (corrected=%.4f V). Now set a second known voltage and run 'adc <V>'.\r\n",
	     voltage, raw, corrected);
    return;
  }

  const float v1 = shellContext->adcCalFirstPoint->voltage;
  const float m1 = shellContext->adcCalFirstPoint->raw;
  const float v2 = voltage;
  const float m2 = raw;

  const float denom = (m2 - m1);
  if (std::fabs(denom) < 1e-3f) {
    chprintf(lchp, "adc: invalid points (raw delta too small): m1=%.4f m2=%.4f\r\n", m1, m2);
    return;
  }

  const float scale = (v2 - v1) / denom;
  const float bias = v1 - (scale * m1);

  const int scaleIdx = Persistant::Parameter::findIndex("adc.psbat.scale");
  const int biasIdx = Persistant::Parameter::findIndex("adc.psbat.bias");
  if (scaleIdx <= 0 || biasIdx <= 0) {
    chprintf(lchp, "adc: missing parameters adc.psbat.scale/adc.psbat.bias in params_list\r\n");
    return;
  }

  Persistant::Parameter::set("adc.psbat.scale", scale);
  Persistant::Parameter::set("adc.psbat.bias", bias);
  Ressource::storage.store(scaleIdx);
  Ressource::storage.store(biasIdx);

  const float corrected = Adc::getPsBat();
  chprintf(lchp,
	   "adc: V1=%.3f raw1=%.4f, V2=%.3f raw2=%.4f -> scale=%.6f bias=%.6f; now corrected=%.4f V\r\n",
	   v1, m1, v2, m2, scale, bias, corrected);
  shellContext->adcCalFirstPoint.reset();
}

#ifndef CAN_BITRATE
#define CAN_BITRATE -500   // exemple
#endif

// Nombre de chiffres décimaux d'un entier positif
consteval std::size_t digit_count(unsigned int v) {
    std::size_t n = 1;
    while (v >= 10) {
        v /= 10;
        ++n;
    }
    return n;
}

template<int BR>
consteval auto make_bitrate_array() {
    constexpr int abs_br = BR < 0 ? -BR : BR;
    static_assert(abs_br > 0, "CAN_BITRATE must be non-zero");

    constexpr bool mbits = (abs_br >= 1000) && (abs_br % 1000 == 0);
    constexpr unsigned value = mbits ? abs_br / 1000U : abs_br;

    constexpr std::string_view prefix{"can bitrate = "};
    constexpr std::string_view suffix{mbits ? " mbits/s" : " kbits/s"};

    constexpr std::size_t digits = digit_count(value);

    // +1 pour le '\0'
    constexpr std::size_t total = prefix.size() + digits + suffix.size() + 1;

    std::array<char, total> out{};
    char* p = out.data();

    // prefix
    for (char c : prefix) *p++ = c;

    // nombre
    {
        char tmp[10];
        unsigned v = value;
        std::size_t i = 0;
        do {
            tmp[i++] = char('0' + (v % 10));
            v /= 10;
        } while (v);

        while (i--) *p++ = tmp[i];
    }

    // suffix
    for (char c : suffix) *p++ = c;

    // zéro terminal
    *p = '\0';

    return out;
}


#define STR_(x) #x
#define STR(x)  STR_(x)
/** @brief Console command: display CAN node information. */
static void cmd_can(BaseSequentialStream *lchp, int ,const char* const [])
{
  // lambda constexpr évaluée immédiatement -> produit le buffer
  static constexpr auto CAN_BITRATE_STR_ARR = [] {
    return make_bitrate_array<CAN_BITRATE>();
  }();
  
  constexpr bool fdframe = (CAN_BITRATE > 1000) or (CAN_BITRATE < 0);

  chprintf(lchp, "platform = %s version %d; node_id = %u; %s; frame = %s; software version = %02u.%03u\r\n",
	   STR(PLATFORM), HW_VERSION,
           CANSlave::getNodeId(),
	   CAN_BITRATE_STR_ARR.data(),
	   fdframe ? "CAN-FD" : "CAN-2.0",
	   SW_VERSION_MAJOR, SW_VERSION_MINOR);
}



using pGetFunc_t = uint32_t (*) (void);
using pSetFunc_t  = void (*) (uint32_t);


/** @brief Console command: reboot the MCU. */
static void cmd_restart(BaseSequentialStream *lchp, int argc,const char* const argv[])
{
  (void) lchp;
  (void) argc;
  (void) argv;
  systemReset();
}

/** @brief Console command: manage persistent storage entries. */
static void cmd_storage(BaseSequentialStream *lchp, int argc,const char* const argv[])
{
  (void) lchp;
  switch (argc) {
  case 0 : cmd_storage_list(); break;
  case 1 : cmd_storage_display(argv[0]); break;
  case 2 : cmd_storage_set(argv[0], argv[1]); break;
  default: {
    FixedString concat = argv[1];
    for (int i = 2; i < argc; i++) {
      concat += ' ';
      concat += argv[i];
    }
    cmd_storage_set(argv[0], concat.c_str());
  }
  }
}

/** @brief Console command: manage UAVCAN parameters. */
static void cmd_uavparam(BaseSequentialStream *lchp, int argc,const char* const argv[])
{
  (void) lchp;
  switch (argc) {
  case 0 : cmd_storage_list(); break;
  case 1 : cmd_uavcan_storage_display(argv[0]); break;
  case 2 : cmd_uavcan_storage_set(argv[0], argv[1]); break;
  default: {
    FixedString concat = argv[1];
    for (int i = 2; i < argc; i++) {
      concat += ' ';
      concat += argv[i];
    }
    cmd_uavcan_storage_set(argv[0], concat);
    }
  }
}

/** @brief Console command: trigger a panic for watchdog reset. */
static void cmd_panic(BaseSequentialStream *, int ,const char* const [])
{
  // just hang the system to trigger watchdog reset for tuning purpose
  chSysLock();
}

/*
  
 */


/*===========================================================================*/
/* START OF PRIVATE SECTION  : DO NOT CHANGE ANYTHING BELOW THIS LINE        */
/*===========================================================================*/

/*===========================================================================*/
/* Command line related.                                                     */
/*===========================================================================*/


#define SHELL_WA_SIZE   THD_WORKING_AREA_SIZE(2000)




#ifndef CONSOLE_DEV_USB
#define  CONSOLE_DEV_USB 0
#endif

#if CONSOLE_DEV_USB == 0
static const SerialConfig ftdiConfig =  {
  115200,
  0,
  USART_CR2_STOP1_BITS | USART_CR2_LINEN,
  0
};
#endif



  
#if CH_DBG_STATISTICS
/** @brief Gather per-thread CPU usage data. */
static void stampThreadCpuInfo (ThreadCpuInfo *ti);
static float stampThreadGetCpuPercent (const ThreadCpuInfo *ti, const uint32_t idx);
static float stampISRGetCpuPercent (const ThreadCpuInfo *ti);
static rttime_t get_thread_delta(const thread_t *tp, rttime_t current_time);
#endif

static void cmd_uid(BaseSequentialStream *lchp, int argc,const char* const argv[]) {
  (void)argv;
  if (argc > 0) {
     chprintf(lchp, "Usage: uid\r\n");
    return;
  }

  for (uint32_t i=0; i< UniqProcessorIdLen; i++)
    chprintf(lchp, "[%x] ", UniqProcessorId[i]);
  chprintf(lchp, "\r\n");
}


/** @brief Console command: print memory usage statistics. */
static void cmd_mem(BaseSequentialStream *lchp, int argc,const char* const argv[]) {
  (void)argv;
  if (argc > 0) {
    chprintf(lchp, "Usage: mem\r\n");
    return;
  }

  chprintf(lchp, "core free memory : %u bytes\r\n", chCoreGetStatusX());
  size_t threadHeapFree, largestThreadBlock;
  chHeapStatus(nullptr, &threadHeapFree, &largestThreadBlock);
  chprintf(lchp, "thread heap free : %u bytes (largest block %u)\r\n",
           threadHeapFree, largestThreadBlock);

#if CH_HEAP_SIZE != 0
  chprintf(lchp, "application heap free : %u bytes\r\n", getHeapFree());
#endif
  
}



#if  CH_DBG_STATISTICS
/** @brief Console command: print thread stack/CPU usage. */
static void cmd_threads(BaseSequentialStream *lchp, int argc,const char * const argv[]) {
  static const char *states[] = {CH_STATE_NAMES};
  thread_t *tp = chRegFirstThread();
  (void)argv;
  (void)argc;
  float totalTicks=0;
  float idleTicks=0;

  auto& threadCpuInfo = shellContext->threadCpuInfo;
  
  stampThreadCpuInfo (&threadCpuInfo);
  
  chprintf (lchp, "    addr    stack  frestk prio refs  state        time 	 percent        name\r\n");
  uint32_t idx=0;
   do {
#if defined(CH_DBG_SYSTEM_STATE_CHECK) &&  CH_DBG_SYSTEM_STATE_CHECK    
    chprintf (lchp, "%.8lx %.8lx %6lu %4lu %4lu %9s %9lu   %.2f%%    	%s\r\n",
              (uint32_t)tp, (uint32_t)tp->ctx.sp,
              get_stack_free(tp),
              (uint32_t)tp->hdr.pqueue.prio, (uint32_t)(tp->refs - 1),
              states[tp->state],
              (uint32_t)RTC2MS(STM32_SYSCLK, tp->stats.cumulative),
              stampThreadGetCpuPercent (&threadCpuInfo, idx),
              chRegGetThreadNameX(tp));
#else
    chprintf (lchp, "%.8lx %.8lx %4lu %4lu %9s %9lu   %.2f%%    	%s\r\n",
              (uint32_t)tp, (uint32_t)tp->ctx.sp,
              (uint32_t)tp->hdr.pqueue.prio, (uint32_t)(tp->refs - 1),
              states[tp->state],
              (uint32_t)RTC2MS(STM32_SYSCLK, tp->stats.cumulative),
              stampThreadGetCpuPercent (&threadCpuInfo, idx),
              chRegGetThreadNameX(tp));

#endif
    totalTicks = threadCpuInfo.totalTicks;
    if (idx < MAX_CPU_INFO_ENTRIES && strcmp(chRegGetThreadNameX(tp), "idle") == 0)
    idleTicks = threadCpuInfo.ticks[idx];
    tp = chRegNextThread((thread_t *)tp);
    idx++;
  } while (tp != NULL);

  const float idlePercent = (totalTicks > 0.f) ? ((idleTicks*100.f)/totalTicks) : 0.f;
  const float cpuPercent = 100.f - idlePercent;
  chprintf (lchp, "Interrupt Service Routine 		     %9lu   %.2f%%    	ISR\r\n",
            (uint32_t)RTC2MS(STM32_SYSCLK,threadCpuInfo.totalISRTicks),
            stampISRGetCpuPercent(&threadCpuInfo));
  chprintf (lchp, "\r\ncpu load = %.2f%%\r\n", cpuPercent);
}
#endif

namespace {
  void shellPrint(const char *text) {
    streamWrite(chp, reinterpret_cast<const uint8_t *>(text), strlen(text));
  }

  void shellExecute(int argc, const char *const *argv) {
    if (argc == 0) return;
    for (auto command = commands; command->sc_name; ++command) {
      if (strcasecmp(command->sc_name, argv[0]) == 0) {
        command->sc_function(chp, argc - 1, argv + 1);
        return;
      }
    }
    chprintf(chp, "Commande inconnue : %s\r\n", argv[0]);
  }

  const char **shellComplete(int argc, const char *const *argv) {
    auto **matches = shellContext->completions;
    size_t count = 0;
    for (auto command = commands; command->sc_name; ++command) {
      if (argc == 0 || (argc == 1 &&
          strncmp(command->sc_name, argv[0], strlen(argv[0])) == 0)) {
        matches[count++] = command->sc_name;
      }
    }
    matches[count] = nullptr;
    return matches;
  }

  void shellInterrupt() { shellPrint("^C\r\n"); }

  THD_FUNCTION(shellWorker, arg) {
    auto& context = *static_cast<ShellContext *>(arg);
    // chp is made visible by start() before the worker can run.
    chprintf(chp, "ChibiOS/RT Enhanced Shell\r\n");
    microrl_init(&context.lineEditor, shellPrint);
    microrl_set_execute_callback(&context.lineEditor, shellExecute);
    microrl_set_complete_callback(&context.lineEditor, shellComplete);
    microrl_set_sigint_callback(&context.lineEditor, shellInterrupt);
    while (true) {
      uint8_t c;
      if (streamRead(chp, &c, 1) == 1) microrl_insert_char(&context.lineEditor, c);
    }
  }
}

static void cmd_info(BaseSequentialStream *stream, int, const char *const []) {
  chprintf(stream, "Kernel: %s\r\nBoard: %s\r\n", CH_KERNEL_VERSION, BOARD_NAME);
  chprintf(stream, "MCU ID: 0x%08lx\r\nBuild: %s %s\r\n",
           static_cast<unsigned long>(DBGMCU->IDCODE), __DATE__, __TIME__);
  cmd_can(stream, 0, nullptr);
}

DeviceStatus ShellRole::subscribe(UAVCAN::Node& node) {
  m_node = &node;
  return {DeviceStatus::SHELL_ROLE};
}

DeviceStatus ShellRole::start(UAVCAN::Node&) {
  if (!boardResource.tryAcquire(HWResource::LPUART_1, HWResource::PA02, HWResource::PA03)) {
    return {DeviceStatus::SHELL_ROLE, DeviceStatus::CONFLICT};
  }
  auto releaseResources = [] {
    boardResource.release(HWResource::LPUART_1, HWResource::PA02, HWResource::PA03);
  };
  void *memory = malloc_m(sizeof(ShellContext));
  if (!memory) {
    releaseResources();
    return {DeviceStatus::SHELL_ROLE, DeviceStatus::HEAP_FULL};
  }
  shellContext = new (memory) ShellContext{};
  auto releaseContext = [&] {
    shellContext->~ShellContext();
    free_m(shellContext);
    shellContext = nullptr;
    releaseResources();
  };
  if (!consolePrintfStart()) {
    releaseContext();
    return {DeviceStatus::SHELL_ROLE, DeviceStatus::HEAP_FULL};
  }
  if (sdStart(&CONSOLE_DEV_SD, &ftdiConfig) != MSG_OK) {
    consolePrintfStop();
    releaseContext();
    return {DeviceStatus::SHELL_ROLE, DeviceStatus::NOT_RESPONDING};
  }
  // The creator runs at NORMALPRIO; the worker has lower priority and cannot
  // run until after the following assignment (no blocking operation in between).
  thread_t *worker = chThdCreateFromHeap(nullptr, SHELL_WA_SIZE, "Enhanced_shell",
                                        NORMALPRIO - 1, shellWorker, shellContext);
  if (!worker) {
    sdStop(&CONSOLE_DEV_SD);
    consolePrintfStop();
    releaseContext();
    return {DeviceStatus::SHELL_ROLE, DeviceStatus::HEAP_FULL};
  }
  chp = reinterpret_cast<BaseSequentialStream *>(&CONSOLE_DEV_SD);
  return {DeviceStatus::SHELL_ROLE};
}

namespace {
  /**
   * @brief Visitor used by console commands to pretty-print parameter values.
   * @details Matches the runtime StoredValue kind (int/float/bool/string/empty)
   *          and emits a human-readable line through DebugTrace.
   */
  struct OverloadDyn {
    void operator()(const ssize_t i, const frozen::string& name, Persistant::NoValue) const {
      DebugTrace("store %d '%s' has no value !!", i, name.data());
    }
    void operator()(const ssize_t i, const frozen::string& name, Persistant::Integer j) const {
      if (j > 0) {
	DebugTrace("store %d '%s'  is Integer = %lld 0x%llx 0b%s", i, name.data(), j, j, binary_fmt(j, 0));
      } else {
	DebugTrace("store %d '%s'  is Integer = %lld", i, name.data(), j);
      }
    }
    void operator()(const ssize_t i, const frozen::string& name, bool b) const {
      DebugTrace("store %d '%s'  is Bool = %d", i, name.data(), b);
    }
    void operator()(const ssize_t i, const frozen::string& name, float f) const {
      DebugTrace("store %d '%s'  is Float = %f", i, name.data(), f);
    }
    void operator()(const ssize_t i, const frozen::string& name, const Persistant::StoredString &s) const {
      DebugTrace("store %d '%s'  is String = %s", i, name.data(),  s.c_str());
    }
  };

  /** @brief Match a parameter name against a simple pattern. */
  bool match(const frozen::string&  s, etl::string_view pat) {
    // frozen::string lacks starts_with/ends_with/contains, so adapt via views.
    const etl::string_view haystack{s.data(), s.size()};

    if (pat.starts_with('^')) {
      const auto needle = pat.substr(1);
      return haystack.size() >= needle.size() &&
	     etl::string_view(haystack.data(), needle.size()) == needle;
    }
    if (pat.ends_with('$')) {
      const auto needle = pat.substr(0, pat.size() - 1);
      return haystack.size() >= needle.size() &&
	     etl::string_view(haystack.data() + (haystack.size() - needle.size()), needle.size()) == needle;
    }
    // contains: fallback to simple find
    return haystack.find(pat) != etl::string_view::npos;
  }

  /** @brief List parameters, optionally filtered by a pattern. */
  void cmd_storage_list(etl::string_view partial)
  {
    bool matchOnce = false;
    
    for (ssize_t i=0; i < Persistant::params_list_len; i++) {
      const frozen::string& paramName =  std::next(Persistant::frozenParameters.begin(), i)->first;
      if (not partial.empty()) {
	if (not match(paramName, partial))
	  continue;
      }
      matchOnce = true;
      Persistant::Parameter::find(i).first.visit([&](const auto& param_ptr) {
	OverloadDyn{}(i, paramName, param_ptr);  
      });
    }
    if (not matchOnce) {
      DebugTrace("ERROR : parameter %.*s not valid", partial.size(), partial.data());
    }
    DebugTrace("\n");
  }
  
  /** @brief Display a parameter by name or index string. */
  void cmd_storage_display(const char* key)
  {
    ssize_t index;
    if (auto opt = parse_value_int(key)) {
      index = opt.value();
      if (index <= 0) {
	DebugTrace("ERROR : parameter %d not valid", index);
	return;
      } 
      if (static_cast<size_t>(index) >= frozenParameters.size()) {
	DebugTrace("ERROR : parameter index %d out of bound", index);
	return;
      }
      const auto& frozen_key =  std::next(frozenParameters.begin(), index)->first;
      key = frozen_key.data();
    } else {
      index = Persistant::Parameter::findIndex(key);
    }
    if (index <= 0) {
      cmd_storage_list(key);
    } else {
      if (const auto& p = Persistant::Parameter::find(index);
	  std::holds_alternative<Persistant::NoValue>(p.first)) {
	chprintf(chp, "index %u is out of bound\r\n", index);
	return;
      }

      Persistant::Parameter::find(index).first.visit([&](const auto& param_ptr) {
	OverloadDyn{}(index, frozen::string(key), param_ptr);
      });
    }
  }

  /** @brief Display a parameter by index. */
  void cmd_storage_display(ssize_t index)
  {
    if (index <= 0) {
      DebugTrace("ERROR : parameter index %d not valid", index);
    } else {
      const auto& key =  std::next(frozenParameters.begin(), index)->first;
      Persistant::Parameter::find(index).first.visit([&](const auto& param_ptr) {
	OverloadDyn{}(index, frozen::string(key), param_ptr);
      });
    }
  }
  
  /** @brief Set a parameter by name or index string. */
  void cmd_storage_set(const char* key, const char* value)
  {
    ssize_t index;
    if (auto opt = parse_value_int(key)) {
      index = opt.value();
    } else {
      index = Persistant::Parameter::findIndex(key);
    }
    if (index <= 0) {
      DebugTrace("ERROR : parameter %s not valid", key);
    } else {
      const auto& p = Persistant::Parameter::find(index);
      if (std::holds_alternative<Persistant::NoValue>(p.first)) {
	chprintf(chp, "index %u is out of bound\r\n", index);
	return;
      }
      Persistant::Parameter::set(p, value);
      Ressource::storage.store(index);
      cmd_storage_display(index);
      Ressource::storage.restore(index);
      cmd_storage_display(index);
    }
  }

  /*
    struct uavcan_protocol_param_GetSetRequest {
      uint16_t index;
      struct uavcan_protocol_param_Value value;
      struct { uint8_t len; uint8_t data[92]; }name;
    };

enum uavcan_protocol_param_Value_type_t {
    UAVCAN_PROTOCOL_PARAM_VALUE_EMPTY,
    UAVCAN_PROTOCOL_PARAM_VALUE_INTEGER_VALUE,
    UAVCAN_PROTOCOL_PARAM_VALUE_REAL_VALUE,
    UAVCAN_PROTOCOL_PARAM_VALUE_BOOLEAN_VALUE,
    UAVCAN_PROTOCOL_PARAM_VALUE_STRING_VALUE,
};
    struct uavcan_protocol_param_Value {
      enum uavcan_protocol_param_Value_type_t union_tag;
      union {
        struct uavcan_protocol_param_Empty empty;
        int64_t integer_value;
        float real_value;
        uint8_t boolean_value;
      struct { uint8_t len; uint8_t data[128]; }string_value;
      };
    };

    enum uavcan_protocol_param_NumericValue_type_t {
    UAVCAN_PROTOCOL_PARAM_NUMERICVALUE_EMPTY,
    UAVCAN_PROTOCOL_PARAM_NUMERICVALUE_INTEGER_VALUE,
    UAVCAN_PROTOCOL_PARAM_NUMERICVALUE_REAL_VALUE,
    };
    
    
    struct uavcan_protocol_param_NumericValue {
    enum uavcan_protocol_param_NumericValue_type_t union_tag;
    union {
    struct uavcan_protocol_param_Empty empty;
    int64_t integer_value;
    float real_value;
    };
    };
    
    struct uavcan_protocol_param_GetSetResponse {
      struct uavcan_protocol_param_Value value;
      struct uavcan_protocol_param_Value default_value;
      struct uavcan_protocol_param_NumericValue max_value;
      struct uavcan_protocol_param_NumericValue min_value;
      struct { uint8_t len; uint8_t data[92]; }name;
    };


  */
  
  /** @brief Display a parameter using UAVCAN GetSet response formatting. */
  void cmd_uavcan_storage_display(etl::string_view key)
  {
    int index = -1;
    if (auto opt = parse_value_int(key)) {
      index = opt.value();
    } 
    uavcan_protocol_param_GetSetRequest req = {
      .index = static_cast<std::uint16_t>(std::clamp(index, 0,
					  static_cast<int>(std::numeric_limits<std::uint16_t>::max()))),
      .value = {
	.union_tag =  UAVCAN_PROTOCOL_PARAM_VALUE_EMPTY,
	.integer_value = 0
      },
      .name = {
	.len = static_cast<uint8_t>(index == 0 ? strnlen(key.data(), key.length()) : 0),
	.data = 0
      }
    };
    if (index < 0)
      memcpy(req.name.data, key.data(), strnlen(key.data(), key.length()));
    
    uavcan_protocol_param_GetSetResponse resp;
    getSetResponse(req, resp);
    
    FixedString respStr;
    respStr << resp;
    DebugTrace("resp = %s", respStr.c_str());
  }

  
  /** @brief Set a parameter using UAVCAN GetSet request formatting. */
  void cmd_uavcan_storage_set(etl::string_view key, etl::string_view valuestr)
  {
    uint16_t index = 0;
    if (auto opt = parse_value_int(key)) {
      index = opt.value();
    } 
    uavcan_protocol_param_GetSetRequest req = {
      .index = index,
      .value = {
	.union_tag =  UAVCAN_PROTOCOL_PARAM_VALUE_EMPTY,
	.integer_value = 0
      },
      .name = {
	.len = static_cast<uint8_t>(index == 0 ? strnlen(key.data(), key.length()) : 0),
	.data = 0
      }
    };
    if (index == 0)
      memcpy(req.name.data, key.data(), strnlen(key.data(), key.length()));
    
    const Value value = parse_value(valuestr);
    req.value.union_tag  = static_cast<uavcan_protocol_param_Value_type_t>(value.index());
    switch (value.index()) {
    case 0:
      DebugTrace("empty"); break;
    case 1:
      req.value.integer_value = std::get<int64_t>(value);
      break;
    case 2:
      req.value.real_value = std::get<float>(value);
      break;
    case 3:
      req.value.boolean_value = std::get<bool>(value);
      break;
    case 4:
      req.value.string_value.len = std::get<FixedString>(value).length();
      strcpy(reinterpret_cast<char *>(req.value.string_value.data),
	     std::get<FixedString>(value).c_str());
      break;
    default:
      DebugTrace("OOPS");
    }
    
    uavcan_protocol_param_GetSetResponse resp;
    const auto [stoIdx, _] = getSetResponse(req, resp);
    Ressource::storage.store(stoIdx);
    
    FixedString respStr;
    respStr << resp;
    DebugTrace("resp = %s", respStr.c_str());
  }


  /** @brief Parse a string into a typed parameter value. */
  Value parse_value(etl::string_view input) {
    // 1. Trim left/right
    while (!input.empty() && std::isspace(input.front())) input.remove_prefix(1);
    while (!input.empty() && std::isspace(input.back())) input.remove_suffix(1);
    
    // 2. Boolean check
    if (input.size() == 1) {
        const char c = input[0];
        if (c == 't' || c == 'T' || c == 'v' || c == 'V') return true;
    }

    // 3. Try int64_t
    int64_t i = 0;
    const auto [p1, ec1] = std::from_chars(input.begin(), input.end(), i);
    if (ec1 == std::errc() && p1 == input.end()) return i;

    // 4. Try float
    float f;
    const auto [p2, ec2] = std::from_chars(input.begin(), input.end(), f);
    if (ec2 == std::errc() && p2 == input.end()) return f;

    // 5. Default to string
    return FixedString{input};
  }


  /** @brief Parse an integer value if possible. */
  std::optional<int> parse_value_int(etl::string_view input)
  {
    const Value v = parse_value(input);
    if (std::holds_alternative<int64_t>(v)) {
      return std::get<int64_t>(v);
    } else {
      return {};
    }
  }


  /** @brief Append a numeric parameter value to the output string. */
  FixedString &  appendFixed(FixedString &str, const uavcan_protocol_param_NumericValue &val)
  {
    FixedString added;
    switch (val.union_tag) {
    case UAVCAN_PROTOCOL_PARAM_NUMERICVALUE_EMPTY :
      added = "{}";
      break;
    case UAVCAN_PROTOCOL_PARAM_NUMERICVALUE_INTEGER_VALUE :
      snprintf(added.begin(), added.capacity(), "%lld", val.integer_value);
      break;
    case UAVCAN_PROTOCOL_PARAM_NUMERICVALUE_REAL_VALUE :
      snprintf(added.begin(), added.capacity(), "%f", val.real_value);
      break;
      }
    added.uninitialized_resize(strnlen(added.c_str(), added.length()));
    str += added;
    return str;
  }
  
  /** @brief Append a parameter value to the output string. */
  FixedString &  appendFixed(FixedString &str, const uavcan_protocol_param_Value &val)
  {
    FixedString added;
    switch (val.union_tag) {
    case UAVCAN_PROTOCOL_PARAM_VALUE_EMPTY :
      added = "{}";
      break;
    case UAVCAN_PROTOCOL_PARAM_VALUE_INTEGER_VALUE :
       snprintf(added.begin(), added.size(), "%lld", val.integer_value);
      break;
    case UAVCAN_PROTOCOL_PARAM_VALUE_REAL_VALUE :
      snprintf(added.begin(), added.size(), "%f", val.real_value);
      break;
     case UAVCAN_PROTOCOL_PARAM_VALUE_BOOLEAN_VALUE :
       added =  (val.boolean_value == true) ? "TRUE" : "FALSE";
       break;
     case UAVCAN_PROTOCOL_PARAM_VALUE_STRING_VALUE :
       added = etl::string_view(reinterpret_cast<const char *>(val.string_value.data),
				val.string_value.len);
      break;
    }
    added.uninitialized_resize(strnlen(added.c_str(), added.length()));
    str += added;
    return str;
  }

  /** @brief Append a C string to the output string. */
  FixedString &  appendFixed(FixedString &str, const char *val)
  {
    str += val;
    return str;
  }

  /** @brief Append a raw byte buffer to the output string. */
  FixedString &  appendFixed(FixedString &str, const uint8_t *ptr, size_t len)
  {
    str += FixedString(reinterpret_cast<const char*>(ptr), len);
    return str;
  }

  /** @brief Append a GetSet response summary to the output string. */
  FixedString &  appendFixed(FixedString &str, const uavcan_protocol_param_GetSetResponse &resp)
  {
    appendFixed(str, resp.name.data,  resp.name.len);
    str << " max = " << resp.max_value
	<< " min = " << resp.min_value
	<< " default = " << resp.default_value
	<< " value = "   << resp.value;
    return str;
  }

  
}

#if CH_DBG_STATISTICS
/** @brief Sample per-thread and ISR CPU usage counters. */
static void stampThreadCpuInfo (ThreadCpuInfo *ti)
{
  const thread_t *tp =  chRegFirstThread();
  uint32_t idx=0;
  uint32_t threadCount = 0;
  
  ti->totalTicks =0;
  do {
    rttime_t current_time = tp->stats.cumulative;
    ti->ticks[idx] = shellContext->cpu_window.prev_stats_valid ?
      (float)get_thread_delta(tp, current_time) : (float)current_time;
    ti->totalTicks += ti->ticks[idx];
    shellContext->cpu_window.thread_ref[idx] = (thread_t *)tp;
    shellContext->cpu_window.thread_time[idx] = current_time;
    tp = chRegNextThread ((thread_t *)tp);
    idx++;
    threadCount++;
  } while ((tp != NULL) && (idx < MAX_CPU_INFO_ENTRIES));
  ti->totalISRTicks = shellContext->cpu_window.prev_stats_valid ?
    (float)(currcore->kernel_stats.m_crit_isr.cumulative - shellContext->cpu_window.prev_isr_time) :
    (float)currcore->kernel_stats.m_crit_isr.cumulative;
  ti->totalTicks += ti->totalISRTicks;
  tp =  chRegFirstThread();
  idx=0;
  do {
    ti->cpu[idx] = (ti->totalTicks > 0.f) ? ((ti->ticks[idx]*100.f) / ti->totalTicks) : 0.f;
    tp = chRegNextThread ((thread_t *)tp);
    idx++;
  } while ((tp != NULL) && (idx < MAX_CPU_INFO_ENTRIES));

  for (idx = 0; idx < threadCount; idx++) {
    shellContext->cpu_window.prev_thread_ref[idx] = shellContext->cpu_window.thread_ref[idx];
    shellContext->cpu_window.prev_thread_time[idx] = shellContext->cpu_window.thread_time[idx];
  }
  shellContext->cpu_window.prev_thread_count = threadCount;
  shellContext->cpu_window.prev_isr_time = currcore->kernel_stats.m_crit_isr.cumulative;
  shellContext->cpu_window.prev_stats_valid = 1;
}

/** @brief Return CPU usage percentage for a thread index. */
static float stampThreadGetCpuPercent (const ThreadCpuInfo *ti, const uint32_t idx)
{
  if (idx >= MAX_CPU_INFO_ENTRIES) 
    return -1.f;

  return ti->cpu[idx];
}

/** @brief Return CPU usage percentage attributed to ISRs. */
static float stampISRGetCpuPercent (const ThreadCpuInfo *ti)
{
  return (ti->totalTicks > 0.f) ? (ti->totalISRTicks * 100.0f / ti->totalTicks) : 0.f;
}

static rttime_t get_thread_delta(const thread_t *tp, rttime_t current_time)
{
  uint32_t idx;

  if (!shellContext->cpu_window.prev_stats_valid) {
    return 0;
  }

  for (idx = 0; idx < shellContext->cpu_window.prev_thread_count; idx++) {
    if (shellContext->cpu_window.prev_thread_ref[idx] == tp) {
      return current_time - shellContext->cpu_window.prev_thread_time[idx];
    }
  }

  return 0;
}
#endif // CH_DBG_STATISTICS
#endif // CONSOLE_DEV_SD
#endif // TRACE
