alex31/paparazzi_minican/COMMON/source/nodeParameters.hpp

#pragma once
#include "roleConf.h"
/**
 * @file nodeParameters.hpp
 * @brief Parameter definition list used by the persistent parameter system.
 *
 * This header is intentionally a bare initializer list that is #included inside
 * the constexpr params_list definition (see UAVCAN/persistantParam.cpp). Each
 * entry becomes a Persistant::Parameter (name + bounds + default), and the
 * resulting indices/names are the ones exposed via uavcan.protocol.param.GetSet.
 * Roles are enabled with boolean settings using uppercase ROLE to make them
 * visible in GUI or TUI.
 */
      {"can.terminal_resistor", {.v = true}},
	
      {"uavcan.node_id", {.min = -124, .max = 124, .v = 0}}, // 0 is dynamic, negative is prefered dynamic
      {"uavcan.dynid.fd", {.v = false}},
      {"uavcan.param_set_behavior", {.min = SetRam, .max = SetRamFlashAndReboot, .v = SetRamFlash}},
	
      {"bus.i2c.pullup_resistor", {.v = true}},
      // I²C frequency : valid values : 100, 400, 1000
      {"bus.i2c.frequency_khz", {.min = 100, .max = 1000, .v = 400}},
      // shared baudrate for all roles that use usart (but smart servo which use autobaud)
      // 0 is reserved for ROLE.gnss.ubx to trigger UBX auto-baud probing
      // and GPS reconfiguration over UBX on startup.
      {"bus.serial.baudrate", {.min = 0, .max = 460'800, .v = 115'200}},
      {"hardware.nickname", {.v = "nickname"}},
      // Identification LED + UAVCAN management + configured shell; other roles stay stopped.
      // Boot value selects roles; after normal startup, live changes affect only the LED.
      {"ROLE.identification", {.v = true}},
#ifdef TRACE
      // Diagnostic UART J3, allocated only on activation; restart required.
      {"ROLE.shell", {.v = false}},
#endif
	
      {"ROLE.health.survey", {.v = true}},
      //      {"role.health.survey.periodms", {.min = 100, .max = 10'000, .v = 1'000}},

#if USE_SERVO_ROLE
      {"ROLE.servo.pwm", {.v = false}},
      {"role.servo.pwm.ch1-4.frequency", {.min=50, .max=1000, .v = 50}},
      {"role.servo.pwm.ch1-4.shot125", {.v = false}},
      {"role.servo.pwm.ch5-7.frequency", {.min=50, .max=1000, .v = 50}},
      {"role.servo.pwm.ch5-7.shot125", {.v = false}},
      {"role.servo.pwm.map_index1", {.min=0, .max=124, .v = 0}},
      // when pins are shared between timer and other peripherals, select
      // the channels that are in use, other will be free
      // bit0=PA08, bit1=PA09, bit2=PA10, bit3=PA11, bit4=PB04, bit5=PA04, bit6=PB07
      {"role.servo.pwm.channel_mask", {.min=0b0000001, .max=0b1111111, .v = 0b0001111}},
	
      {"ROLE.servo.smart", {.v = false}},
      {"role.servo.smart.map_index1", {.min=0, .max=124, .v = 0}},
      {"role.servo.smart.num_servos",  {.min=1, .max=8, .v = 1}},
      {"role.servo.smart.status_frequency",  {.min=0, .max=100, .v = 0}}, // in Hz, 0 is no reporting
#endif

#if USE_ESC_DSHOT_ROLE
      {"ROLE.esc.dshot", {.v = false}},
      {"role.esc.dshot.map_index1", {.min=0, .max=19, .v = 0}},
      // Mask is: msb CH4 CH3 CH2 CH1 lsb.
      {"role.esc.dshot.channel_mask", {.min=0b0001, .max=0b1111, .v = 0b0001}},
      {"role.esc.dshot.cmd_rate",  {.min=100, .max=1000, .v = 100}},
      {"role.esc.dshot.rpm_freq_div",  {.min=0, .max=1000, .v = 0}}, // CAN publication divider; 0 disables publication
      {"role.esc.dshot.motor_poles", {.min=2, .max=100, .v = 2}}, // Even pole count, shared by all motors
#endif

#if USE_GPS_UBX_ROLE
      {"ROLE.gnss.ubx", {.v = false}},
#endif

#if USE_RC_SBUS_ROLE
      {"ROLE.sbus", {.v = false}},
      // Sending all SBUS frames over CAN would consume 8% of the bandwidth; this must be optimized.
      // Only the active channels are sent (1 = active, 0 = inactive).
      {"role.sbus.channel_mask", {.min=0, .max=0b1111'1111'1111'1111, .v = 0b1111'1111'1111'1111}},
      // in case there is multiple RC, each RC must have a unique ID
      {"role.sbus.id", {.min=0, .max=0xff, .v = 0}},
      // true: UART-level non-inverted signal (debug with USB-UART dongle)
      // false: real SBUS signal, inversion handled by USART peripheral.
      {"role.sbus.debug_uart_ttl", {.v = false}},
#endif

#if USE_SERIAL_STREAM_ROLE
      {"ROLE.tunnel.serial", {.v = false}},
      {"role.tunnel.serial.protocol", {.min = 0, .max = 255, .v = 0}},
      {"role.tunnel.serial.channel_id", {.min = 0, .max = 255, .v = 0}},
#endif

#if USE_BARO_MPL3115A2_ROLE
      {"ROLE.i2c.barometer.mpl3115a2", {.v = false}},
#endif

#if USE_QMC5883_ROLE
      // driver fixes ODR=50Hz and oversampling=256, continuous.
      // range is the only configurable parameter
      {"ROLE.i2c.magnetometer.q5883", {.v = false}},
      {"role.i2c.magnetometer.q5883.range", {.min = 2, .max = 8, .v = 2}},
      {"role.i2c.magnetometer.q5883.rot_deg", {.min = 0, .max = 270, .v = 0}},
      {"role.i2c.magnetometer.q5883.sensor_id", {.min = 0, .max = 250, .v = 0}},
#endif

#if USE_LED2812_ROLE
      {"ROLE.led2812", {.v = false}},	
      {"role.led2812.led_number", {.min = 1, .max = 8, .v = 8}},	
#endif

#if USE_MICROPHONE_ROLE
      {"ROLE.adc.microphone.im68a130", {.v = false}},
      {"role.adc.microphone.period_ms", {.min = 50, .max = 1000, .v = 200}},
#endif

#if USE_OPT4060_ROLE
      {"ROLE.i2c.light.opt4060", {.v = false}},
      // Preferred address; startup also probes the other three strap values.
      {"role.i2c.light.opt4060.address", {.min = 0x44, .max = 0x47, .v = 0x44}},
      {"role.i2c.light.opt4060.publish_hz", {.min = 1, .max = 200, .v = 10}},
      // 0 or publish_hz: synchronous. Above publish_hz: on change. Below: error.
      {"role.i2c.light.opt4060.scan_hz", {.min = 0, .max = 200, .v = 0}},
      {"role.i2c.light.opt4060.delta_rel_pct", {.min = 0.0f, .max = 100.0f, .v = 5.0f}},
      {"role.i2c.light.opt4060.delta_abs", {.min = 0, .max = 0x3FFFFFF, .v = 1024}},
      {"role.i2c.light.opt4060.heartbeat_ms", {.min = 0, .max = 60'000, .v = 1000}},
      {"role.i2c.light.opt4060.sensor_id", {.min = 0, .max = 255, .v = 0}},
      // INT on PA8; false uses polling without reserving PA8.
      {"role.i2c.light.opt4060.use_interrupt", {.v = true}},
#endif

#if USE_VL53L4CX_ROLE
      {"ROLE.i2c.range.vl53l4cx", {.v = false}},
      {"role.i2c.range.vl53l4cx.period_ms", {.min = 100, .max = 1000, .v = 200}},
      {"role.i2c.range.vl53l4cx.sensor_id", {.min = 0, .max = 255, .v = 0}},
#endif

#if USE_TEMPLATE_ROLE
      {"ROLE.template", {.v = false}},
      {"role.template.log_every", {.min = 0, .max = 1000, .v = 0}},
#endif

      // Optional linear correction on the measured battery voltage (psBat):
      // V_corrected = V_raw * adc.psbat.scale + adc.psbat.bias
      // ADC survey and shell calibration use these independently of the
      // optional voltmeter display role.
      {"adc.psbat.scale", {.min = 0.5f, .max = 1.5f, .v = 1.0f}},
      {"adc.psbat.bias", {.min = -5.0f, .max = 5.0f, .v = 0.0f}},

#if USE_VOLTMETER_ROLE
      {"ROLE.voltmeter", {.v = false}},
      {"role.voltmeter.cells", {.min = 2, .max = 6, .v = 4}},
      {"role.voltmeter.brightness", {.min = 0.0f, .max = 1.0f, .v = 0.2f}},

      // If >0 and a valid uavcan.equipment.gnss.Fix2 is received recently,
      // blank the WS2812 LEDs when ground speed is above this threshold.
      // Set to 0 to disable this behavior.
      {"role.voltmeter.gps_speed_off_mps", {.min = 0.0f, .max = 100.0f, .v = 3.0f}},
	
#endif
