alex31/paparazzi_minican/COMMON/source/roleStatus.hpp

/**
 * @file roleStatus.hpp
 * @brief Device status and error reporting helpers.
 */
#pragma once
#include "frozen/map.h"
#include <etl/to_string.h>

/// Helper to build a frozen::map from a std::array.
template <typename K, typename V, std::size_t N>
constexpr frozen::map<K, V, N> make_frozen_map(std::array<std::pair<K, V>, N> arr) {
    return frozen::map<K, V, N>(arr);
}


#define MKP(e)  std::pair{e, #e}

/**
 * @brief Status object describing a device role and potential error.
 */
struct DeviceStatus {
  enum Source : uint8_t {
    ALL, MFS, RESOURCE, SERVO_ROLE, SERVO_PWM, SERVO_SMART,
    MPL3115A2, ESC_DSHOT, RC_SBUS, SERIAL_STREAM, LED2812_ROLE, GPS_ROLE,
    MAG_QMC5883, VOLTMETER_ROLE, TEMPLATE_ROLE, FIRMWARE_UPDATE, I2C, SPI, MEMORY,
    MICROPHONE, OPT4060, VL53L4CX, SHELL_ROLE, NUM_SOURCES
  };
  enum Error : uint8_t {
    OK, NOT_FOUND, INVALID_PARAM, HETEROGENEOUS_BAUDS,
    NOT_RESPONDING, CONFLICT, I2C_TIMOUT, I2C_FREQ_INVALID, NB_ROLE_TOO_LARGE,
    INVALID_PWM_MASK, HEAP_FULL, DMA_HEAP_FULL, DMA_UNAVAILABLE, NUM_ERRORS
  };
  constexpr DeviceStatus(Source s, Error e = OK,
	       uint16_t spe = 0) : source(s), err(e), specific(spe) {}
  constexpr DeviceStatus(const DeviceStatus&) = default;
  void set(Error e, uint16_t spe=0) {
    err = e; specific = spe;
  }
  
  DeviceStatus() = delete;
  // convert to true if no error
  explicit operator bool() const {return err == OK;}
  
  Source source;
  Error  err;
  uint16_t specific;
  
  static constexpr auto srcName = make_frozen_map(std::to_array({
	MKP(ALL),
	MKP(MFS),
	MKP(RESOURCE),
	MKP(SERVO_ROLE),
	MKP(SERVO_PWM),
	MKP(SERVO_SMART),
	MKP(MPL3115A2),
	MKP(ESC_DSHOT),
	MKP(RC_SBUS),
	MKP(SERIAL_STREAM),
      MKP(LED2812_ROLE),
      MKP(GPS_ROLE),
      MKP(MAG_QMC5883),
      MKP(VOLTMETER_ROLE),
      MKP(TEMPLATE_ROLE),
      MKP(FIRMWARE_UPDATE),
      MKP(I2C),
      MKP(SPI),
      MKP(MEMORY),
      MKP(MICROPHONE),
      MKP(OPT4060),
      MKP(VL53L4CX),
      MKP(SHELL_ROLE)
      }));

  static constexpr auto errName = make_frozen_map(std::to_array({
	MKP(OK),
	MKP(NOT_FOUND),
	MKP(INVALID_PARAM),
	MKP(HETEROGENEOUS_BAUDS),
	MKP(NOT_RESPONDING),
	MKP(I2C_TIMOUT),
	MKP(I2C_FREQ_INVALID),
	MKP(NB_ROLE_TOO_LARGE),
	MKP(INVALID_PWM_MASK),
	MKP(HEAP_FULL),
	MKP(DMA_HEAP_FULL),
	MKP(DMA_UNAVAILABLE),
	MKP(CONFLICT)
      }));

  static_assert(srcName.size() == NUM_SOURCES);
  static_assert(errName.size() == NUM_ERRORS);
  
  /** @brief Format the status as a short human-readable string. */
  etl::string<64> describe() const {
    etl::string<64> out;
    out = "SRC=";
    out += srcName.at(source);
    out += " ERR=";
    out += errName.at(err);
    out += " SPEC=";
    
    etl::to_string(specific, out, true);  // en base 10, append instead of overwrite
    return out;
  }
};

static_assert(sizeof(DeviceStatus) == sizeof(int));

/**
 * @brief Bit flags for NodeStatus specific_code reporting.
 *
 * Usage depends on the node status mode:
 * - OPERATIONAL: low nibble = current ADC status; high nibble = latched since boot.
 * - SOFTWARE_UPDATE: progress in KiB (see firmwareUpdate.cpp).
 * - MAINTENANCE: reserved for future/board-specific meaning.
 */
enum SpecificCodeBits : uint16_t {
  SPEC_PSBAT_UNDERVOLT_CURRENT = 1u << 0,
  SPEC_PSBAT_OVERVOLT_CURRENT  = 1u << 1,
  SPEC_CORETEMP_OVER_CURRENT  = 1u << 2,
  SPEC_CORETEMP_UNDER_CURRENT = 1u << 3,
  SPEC_PSBAT_UNDERVOLT_LIFETIME = 1u << 4,
  SPEC_PSBAT_OVERVOLT_LIFETIME  = 1u << 5,
  SPEC_CORETEMP_OVER_LIFETIME  = 1u << 6,
  SPEC_CORETEMP_UNDER_LIFETIME = 1u << 7,
  SPEC_WATCHDOG_RESET_FIRED = 1u << 8,
  SPEC_CURRENT_MASK = SPEC_PSBAT_UNDERVOLT_CURRENT
                     | SPEC_PSBAT_OVERVOLT_CURRENT
                     | SPEC_CORETEMP_OVER_CURRENT
                     | SPEC_CORETEMP_UNDER_CURRENT,
  SPEC_LIFETIME_MASK = SPEC_PSBAT_UNDERVOLT_LIFETIME
                      | SPEC_PSBAT_OVERVOLT_LIFETIME
                      | SPEC_CORETEMP_OVER_LIFETIME
                      | SPEC_CORETEMP_UNDER_LIFETIME,
};
