alex31/paparazzi_minican/COMMON/source/sbusRole.cpp

/**
 * @file sbusRole.cpp
 * @brief SBUS receiver role implementation.
 */
#include "roleConf.h"

#if USE_RC_SBUS_ROLE

#include "sbusRole.hpp"
#include "hardwareConf.hpp"
#include "resourceManager.hpp"


namespace {
  constexpr SIO::DmaUserConfig sbus_rx_dma_cfg{
      .stream = STM32_DMA_STREAM_ID_ANY,
      .dmamux = EXTERNAL_USART_RX_DMAMUX,
  };
  constexpr SIO::DmaUserConfig sbus_tx_dma_cfg{
      .stream = STM32_DMA_STREAM_ID_ANY,
      .dmamux = EXTERNAL_USART_TX_DMAMUX,
  };

  SBUSConfig sbuscfg = {	//Config du sbus de la RC
    .siop = &ExternalSIOD,
    .rx_dma_cfg = sbus_rx_dma_cfg,
    .tx_dma_cfg = sbus_tx_dma_cfg,
#ifdef TRACE
    .errorCb = [](SBUSError err) {DebugTrace("Sbus Err %u", err)},
#else
    .errorCb = nullptr,
#endif
    .frameCb = &Trampoline<&RC_Sbus::maj_rc_cb_frame>::fn,
    .threadWASize = 1024,
    .externallyInverted = false,
  };

  static constexpr uint32_t SBUS_RANGE_MIN   = 200;
  static constexpr uint32_t SBUS_RANGE_MAX   = 1800;
  static constexpr uint32_t SBUS_TARGET_MIN  = 1000;
  static constexpr uint32_t SBUS_TARGET_MAX  = 2000;


  
  /** @brief Map an SBUS channel value to PWM microseconds. */
  uint32_t scale_to_pwm_microseconds(uint32_t sbus);
}

/** @brief No subscriptions required for SBUS input. */
DeviceStatus RC_Sbus::subscribe(UAVCAN::Node&)
{
  return DeviceStatus(DeviceStatus::RC_SBUS);
}

/** @brief Initialize the SBUS driver and configure channel mapping. */
DeviceStatus RC_Sbus::start(UAVCAN::Node& _node)
{
  using HR = HWResource;
  DeviceStatus status(DeviceStatus::RC_SBUS);
  
  // use serial2 rx
  if (not boardResource.tryAcquire(HR::USART_2, HR::PB04)) {
    return DeviceStatus(DeviceStatus::RESOURCE, DeviceStatus::CONFLICT,
			std::to_underlying(HR::USART_2));
  }
  
  enabledChannels = param_cget<"role.sbus.channel_mask">();
  rcInput.rcin.len = enabledChannels.count();
  rcInput.id = param_cget<"role.sbus.id">();
  // Debug mode for USB-UART dongles: signal is already non-inverted TTL.
  // Normal SBUS receiver path keeps HW inversion in the USART.
  sbuscfg.externallyInverted = param_cget<"role.sbus.debug_uart_ttl">();
  

  if (rcInput.rcin.len > SBUS_NUM_CHANNEL) {
    _node.infoCb("sbus: channel count %u exceeds max %u",
		 rcInput.rcin.len, SBUS_NUM_CHANNEL);
    return DeviceStatus(DeviceStatus::RC_SBUS, DeviceStatus::INVALID_PARAM,
			rcInput.rcin.len);
  }

  node = &_node;
  sbusObjectInit(&sbusd);	//Init et acquisition des trames sbus
  sbusStart(&sbusd, &sbuscfg);
  sbusStartReceive(&sbusd);
  return status;
}

/** @brief Convert an SBUS frame into a UAVCAN RCInput message. */
void RC_Sbus::maj_rc_cb_frame(const SBUSFrame *frame)
{
  size_t outIdx = 0;
  const size_t maxOut = std::min<std::size_t>(rcInput.rcin.len, max_channels);
  
  for (size_t ch = 0; (ch < max_channels) && (outIdx < maxOut); ++ch) {
    if (enabledChannels[ch]) {
      rcInput.rcin.data[outIdx++] = scale_to_pwm_microseconds(frame->channel[ch]);
    }
  }
  rcInput.status = DRONECAN_SENSORS_RC_RCINPUT_STATUS_QUALITY_VALID;
  if (frame->flags & (1 << SBUS_FAILSAFE_BIT))
    rcInput.status |= DRONECAN_SENSORS_RC_RCINPUT_STATUS_FAILSAFE;
  
  rcInput.quality = frame->flags & (1 << SBUS_FRAME_LOST_BIT) ? 0 : 255;
  node->sendBroadcast(rcInput, CANARD_TRANSFER_PRIORITY_HIGH);
}


namespace {
  static constexpr uint32_t SBUS_RANGE_RANGE  = SBUS_RANGE_MAX - SBUS_RANGE_MIN;
  static constexpr uint32_t SBUS_TARGET_RANGE = SBUS_TARGET_MAX - SBUS_TARGET_MIN;

  /** @brief Convert raw SBUS value to PWM pulse width in microseconds. */
  uint32_t scale_to_pwm_microseconds(uint32_t sbus_raw) {
    const uint32_t r = std::clamp(sbus_raw, SBUS_RANGE_MIN, SBUS_RANGE_MAX);
    const uint32_t num = (r - SBUS_RANGE_MIN) * SBUS_TARGET_RANGE;
    return num / SBUS_RANGE_RANGE + SBUS_TARGET_MIN;
  }

}

#endif // USE_RC_SBUS_ROLE
