alex31/paparazzi_minican/COMMON/source/nodeParametersEnum.hpp

/**
 * @file nodeParametersEnum.hpp
 * @brief Enumerations for parameter handling behavior.
 */
#pragma once

/** @brief Actions to take when a parameter is set. */
enum ParamSetBehavior {SetRam, SetRamFlash, SetRamFlashAndReboot};
