alex31/paparazzi_minican/COMMON/source/roleVoltmeter.hpp

#pragma once

#include <ch.h>
#include <hal.h>
#include "UAVCAN/pubSub.hpp"
#include "roleBase.hpp"
#include "roleStatus.hpp"

class RoleVoltmeter final : public RoleBase, public RoleCrtp<RoleVoltmeter> {
public:
  DeviceStatus subscribe(UAVCAN::Node& node) override;
  DeviceStatus start(UAVCAN::Node& node) override;
};
