alex31/paparazzi_minican/(commit log)

2025-07-23 initial commit of reunified project
    [board.cfg]
2025-07-23 add bootloader infrastructure, just skeleton not actual logic
    [board.cfg]
2025-07-23 disable hardware filtering in can config since we are bound to more than 8 messages id
2025-07-23 use system CRCD1, reset currentFileIndex after successful flash for the next one
    [firmwareUpdate.cpp]
2025-07-24 replace std::span with etl::span for coherency
    [MFS.cpp, firmwareUpdate.cpp]
2025-07-24 remove TRACE and printf API in the OPT_SIZE and OPT_SPEED release mode
2025-07-26 explicit yield to make rgb led blink during bootloader load application in flash
2025-07-26 reset the flashAtNextBoot bit even in case of CRC error
    [main.cpp]
2025-07-26 try to ensure that firmware is well flashed before reboot to bootloader, but someting is fishy and rely on timing on the sender side, need to investigate
    [firmwareUpdate.cpp]
2025-07-27 make bootloader more robust to power off during process fo avoid a locked node that need swd flashing
    [firmwareHeader.hpp, firmwareUpdate.cpp, main.cpp, microrlConfig.h]
2025-07-27 swap chTimeDiffX() arguments to compute elapsed time correctly
    [escDshotRole.cpp]
2025-07-27 manage timout when firmware update : if an attempt stall, we permit to let the server restart it
    [firmwareUpdate.cpp]
2025-07-27 compile bootloader without trace on release mode to make it shrink below 12kb, set the flash memory map accordingly
2025-07-28 create HARDWARE directory, eventually kikad source and BOM will populate this place
2025-07-28 fix another off-by-one error
    [servoSmart.cpp]
2025-07-28 updated hardware description
    [board.cfg]
2025-07-29 unified makefile for microcan and minican, now, differences should be handled in modules with conditional compilation
    [MICROCAN.cfg, MINICAN.cfg]
2025-07-29 try to cope with the fact that there is 2 board.cfg, one for microcan, one for minican, but only one board.h
2025-08-01 unified source for minican and microcan, need to be tested on actual hardware
    [MICROCAN.cfg, MINICAN.cfg]
2025-10-24 remove not needed files
    [MICROCAN.cfg, MINICAN.cfg, board.cfg]
2025-11-07 ° make firmware update sequence safer by preprending binary executable with a header that permit to avoid firmware mismatch : only allow firmware with good size, crc, for the given platform and hardw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
    [UAVCanSlave.cpp, firmwareHeader.hpp, firmwareUpdate.cpp, hardwareConf.hpp, main.cpp]
2025-11-07 fix printf format
2025-11-13 add can command to gibe info about statically compiled can frame format and bitrate
2025-11-14 do not activate watchdog reset when compiled with -O0 ; we want to catch segfault with debugger
    [main.cpp]
2025-11-14 filter incorrect data input that led to crash
    [ttyConsole.cpp]
2025-11-14 track prepend script that generate uavcan updatable firmware image
2025-11-14 raise watchdog reset thread priority lo leave the possibility of idle thasj that use all remainiçng cpu
    [main.cpp]
2025-11-14 add a module that manege shared access of i2c master peripheral in case of multiples i2c slave on the bus : should agree on the i2c frequency that is specified in the parameters
2025-11-14 fix management of i2c frequency
    [I2C_periph.cpp, nodeParameters.hpp]
2025-11-17 implement request file message resend after tumeout using threadSuspend / threadResume
2025-11-17 use binary semaphore instead of suspend resume to avoid possible race condition
    [firmwareUpdate.cpp]
2025-11-18 fix request file message resend when the first frame is lost
    [UAVCanSlave.cpp, firmwareUpdate.cpp, firmwareUpdate.hpp, main.cpp]
2025-11-19 fix the CAN and FDCAN timing calculation to match exactly what canable 2.0 use : need to downclock cpu at 160Mhz to match FDCAN timings
    [MiniCAN_v5.ioc, UAVCanHelper.cpp, UAVCanHelper.hpp, UAVCanSlave.cpp, mcuconf.h, roleStatus.hpp]
2025-11-19 fix the CAN and FDCAN timing calculation : revert to 170 Mhz clock source : timing are ok at 2Mhz and 5Mhz, only sample point differ a bit, but continue to work. In the future, will be easy to set 16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
    [MiniCAN_v5.ioc, UAVCanSlave.cpp, mcuconf.h]
2025-11-19 fix startup when using dynamic node info, make canfd one frame dynamic node allocation optionnal
    [UAVCanSlave.cpp, UAVCanSlave.hpp, firmwareUpdate.cpp, main.cpp, nodeParameters.hpp]
2025-11-21 rework the servoPwm role to enable the sharing of pin between pwm and other peripharal when one not need all the 4 pwm output
    [nodeParameters.hpp, roleStatus.hpp, servoPwm.cpp, ttyConsole.cpp]
2025-11-25 add a gpsUbxDecoder, for now not wired by the gps role, and state machine is a naive byte by byte impl
2025-11-25 manage status and print debug message when it fails
    [gpsUbxDecoder.cpp, gpsUbxDecoder.hpp]
2025-11-26 fix stack overflow, use Fix2 instead of obsolete Fix
    [gpsUbxDecoder.cpp, gpsUbxMessageDef.hpp, gpsUbxRole.cpp, gpsUbxRole.hpp, servoSmart.cpp]
2025-11-26 fix : use a static buffer in DMA section for uartReceiveTimeout
    [gpsUbxDecoder.hpp, gpsUbxRole.cpp, gpsUbxRole.hpp]
2025-11-26 fix small glitch in flag bit definition for SAT message. encode Fix2 covariance field like DronePilot with 6 values
    [gpsUbxMessageDef.hpp, gpsUbxRole.cpp]
2025-11-26 add a thread that report smart_servo states
2025-11-28 fix synamic pin config which avoided to have more than one role on microcan. Add a pattern filter fracility in shell st command
    [mcuconf.h, nodeParameters.hpp, ttyConsole.cpp]
2025-11-28 fix display and uavcan broadcast of init errors
    [UAVCanSlave.cpp, main.cpp, roleStatus.hpp]
2025-11-28 use malloc instead of static buffer for dma buffer
2025-11-28 use a specific dma malloc which allocate memory from a dma capable section
2025-11-28 fix baro role using a non dma capable buffer
    [baro_MPL3115A2_Role.cpp]
2025-11-28 fix a possible use after free if remote file server send a ReadResponse with error.value != OK
    [firmwareUpdate.cpp]
2025-11-28 avoid race condition and factorize release sector buffer code
    [firmwareUpdate.cpp]
2025-11-28 avoid crash when there is ressource conflict between two roles trying to start UART
2025-11-28 start the uart device only if no ressource conflict has been detected
2025-11-29 make sensor_id as configuration parameter in case one want to fit several on an airframe
2025-11-30 fix : i2c roles now use i2cAcquireBus to gain exclusive access to the bus
    [baro_MPL3115A2_Role.cpp, qmc5883Role.cpp]
2025-12-02 Fix a bug where not activating I2C pullup lead to active pulldown instead of leaving floating. Simplifiy hardware compatibility check, so that it does not generate glitches on SDA/SDL that confuse I2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
    [MICROCAN.cfg]
2025-12-03 slow down output rate of error messages so that shell can still be usable
    [UAVCanSlave.cpp, main.cpp]
2025-12-04 try using iqueue -> epic failure
    [serialStreamRole.cpp, serialStreamRole.hpp]
2025-12-05 replace a static buffer with a malloqued one to save BSS if the role is not active
    [serialStreamRole.cpp]
2025-12-05 add doxygen header, report more precise error condition
    [serialStreamRole.cpp, serialStreamRole.hpp]
2025-12-08 replace macro PARAM_CGET(name) with function param_cget<name>()
    [I2C_periph.cpp, UAVCanSlave.cpp, escDshotRole.cpp, gpsUbxRole.cpp, main.cpp, qmc5883Role.cpp, sbusRole.cpp, serialStreamRole.cpp]
2025-12-09 fix top level Makefile to pass build option to submakefile. add entry to flash bootloader and firmware on a newly build board
2025-12-10 role rgbLedRole coded by codex, reviewed by gemini, commited as is, before next mandatory step : human review
    [MICROCAN.cfg, MINICAN.cfg]
2025-12-10 add error checking, resturn error condition instead of asserting
    [escDshotRole.cpp, sbusRole.cpp, servoPwm.cpp]
2025-12-11 do not hang 10 second in bootloader when there is no valid firmware in flash (new device just flashed)
    [board.cfg]
2025-12-11 fix sbus role bugs
    [sbusRole.cpp, sbusRole.hpp]
2025-12-12 fix the segfault when using --specs=nano.specs
    [UAVCanSlave.cpp, mcuconf.h, nodeParameters.hpp, sbusRole.cpp, sbusRole.hpp]
2025-12-12 role ledRgbRole validated and simplified
2025-12-12 codex has wrote a voltemeter role, need to be reviewed and tested
2025-12-12 fix dshot to use a bitmask of effetive timer channels in use : usefull when pins are shared with other peripherals
    [escDshotRole.cpp, escDshotRole.hpp, nodeParameters.hpp]
2025-12-14 wait until adc stability before conversion
    [adcSurvey.cpp]
2025-12-15 voltmeter role tested, add an adc calibration layer
2025-12-15 light off led when ground speed is above threshold to save energy
2025-12-15 parameter set behavior is tunable : on Set, the node can save in ram, or save in ram and flash, or save in ram and flash and reboot
    [UAVCanSlave.cpp, nodeParameters.hpp, nodeParametersEnum.hpp]
2026-01-06 fixes small problems after llm review
    [MFS.cpp, baro_MPL3115A2_Role.cpp, firmwareUpdate.cpp, rgbLeds.cpp, ttyConsole.cpp]
2026-01-06 fix non initialized variable
    [ttyConsole.cpp]
2026-01-07 correctly set VCS_COMMIT option in option field
    [UAVCanSlave.cpp]
2026-01-09 fix setting parameter_set_behavior via uavcan getset
    [UAVCanSlave.cpp]
2026-01-09 microcan has no more an adc channel devoted to get node_id address via a resistor value; fix getPsBat return 0 before MFS paremeters are read
    [MICROCAN.cfg]
2026-01-13 no more use unique mppt message to send node 3.3, battery voltage and core temperature, and use several other messages instead; activate libcanard use of a semaphore to protect memory pool access
2026-01-14 health survey use real voltage limit not dependant of number of cells in battery, specific code reflect software update progression in update mode, and voltage, temperature defaults in operational mo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
    [UAVCanSlave.cpp, UAVCanSlave.hpp, adcSurvey.cpp, adcSurvey.hpp, firmwareUpdate.cpp, healthSurvey.cpp, main.cpp, roleStatus.hpp]
2026-01-15 sbusRole out value in pwm microseconds range between 1000 and 2000
2026-01-16 add a shell command to trigger watchdog reset
    [main.cpp, ttyConsole.cpp]
2026-01-20 add a DOCUMENTATION.md sumary, fix misnommed adc pins in .cfg files
    [MICROCAN.cfg, MINICAN.cfg]
2026-01-24 use new unified names for swap API
    [baro_MPL3115A2_Role.cpp]
2026-01-29 use new jobqueue and fifoObject API (avoid potential UB)
    [serialStreamRole.cpp]
2026-02-02 make all roles that use UART driver to use SIO instead
2026-02-27 add a switch to permit non inverted sbus level to use with non inverted receiver or when making non regression tests with usb serial under linux
    [nodeParameters.hpp, sbusRole.cpp]
2026-03-01 • servo.smart: publish immediate ActuatorStatus on commands (with light anti-flood)
    Add immediate status publication for smart servos in the actuator command path
    so command->status latency is no longer limited by periodic telemetry frequency.
    Changes:
    - Add `ServoSmart::publishImmediateStatus(uint8_t)` API.
    - In `ServoRole::processActuatorArrayCommand()`, trigger immediate status publish
    after applying smart-servo commands.
    - Reuse the same status mapping as periodic publisher (`copy(...)`) to avoid
    format divergence.
    - Keep periodic status thread unchanged (`role.servo.smart.status_frequency`).
    - Add anti-flood behavior:
    - per-actuator minimum publish interva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
    [servoRole.cpp, servoSmart.cpp, servoSmart.hpp]
2026-03-02 fix smart servo speed sign telemetry reporting
    [servoSmart.cpp]
2026-03-03 make smart servo detection and initialisation more robust
2026-03-03 refactor(roles): replace static allocations with dynamic allocation to save memory
    Since roles are optionally launched at runtime, they should only consume memory if activated.
    The previous implementations permanently consumed BSS/Data memory regardless of role usage by using static variables:
    - `servo_sio_storage` and `servo_bus_storage` in `ServoSmartRole`
    - `strip` in `VoltmeterRole`
    - `strip` in `RgbLedRole`
    This commit removes the static storage and cleanly instantiates the objects via the standard heap `new` operator inside the respective `start()` methods. This ensures memory is only allocated if the roles are actually running, saving approximately 1.2 KB of permanent RAM.
    [rgbLedRole.cpp, servoSmart.cpp, voltmeterRole.cpp]
2026-03-04 refactor(roles): use DMA heap for role objects with DMA buffers
    Migrate allocations of role objects containing DMA buffers (LED strips,
    SIO drivers, etc.) from the general heap to the DMA-specific heap via
    malloc_dma. This ensures memory compatibility for DMA controllers on
    all STM32 variants.
    - Introduced try_new_dma<T> helper in RoleBase.hpp to factorize the
    allocation and placement new pattern with error reporting.
    - Refactored RgbLedRole, VoltmeterRole, ServoSmart, SerialStream,
    GpsUBX, and Qmc5883Role to use the new helper.
    - Fixed variable shadowing and missing includes in ServoSmart.
    [gpsUbxRole.cpp, qmc5883Role.cpp, rgbLedRole.cpp, roleBase.hpp, serialStreamRole.cpp, servoSmart.cpp, voltmeterRole.cpp]
2026-03-05 refactor: remove legacy multiplexed-pin path and microcan v3 artifacts
    - drop dynamicPinConfig module and all role/resource branches tied to the old multiplexed connector path
    - simplify role resource acquisition to the single non-multiplexed hardware behavior
    - remove old MicroCAN v3 hardware/docs files no longer part of supported targets
    [I2C_periph.cpp, escDshotRole.cpp, gpsUbxRole.cpp, nodeParameters.hpp, resourceManager.hpp, rgbLedRole.cpp, sbusRole.cpp, serialStreamRole.cpp]
2026-03-05 refactor!: rename minican firmware to microcan v5
    - rename firmware tree minican -> microcan and update top-level build/flash targets
    - rename hardware/docs assets from MINICAN names to MICROCAN names while keeping HW major version V5
    - update platform/app identifiers and macros to microcan (org.pprz.microcanV5, PLATFORM_MICROCAN)
    - refresh documentation links and board references to match the new MicroCAN naming
    BREAKING CHANGE: platform identity string changed from org.pprz.minicanV5 to org.pprz.microcanV5; deployed nodes on old firmware need one-time SWD/transition flashing before in-app updates resume.
    [MICROCAN.cfg, MINICAN.cfg, board.cfg]
2026-04-01 threads: backport cumulative-first windowed CPU stats
    Backport the updated thread CPU reporting so the first sample uses cumulative statistics since boot and later samples use a sliding window between calls.
    Validated with `make` in:
    - bootloader
    - microcan
2026-04-09 feat(servo-pwm): split outputs across TIM1 and TIM3
    [MICROCAN.cfg]
2026-04-09 docs(servo-role): document TIM3 channel mapping and conflicts
2026-09-02 Découple la calibration ADC du rôle voltmètre
2026-09-07 Vérifie à la compilation la durée de vie des configurations UBX
    Le décodeur conserve ses callbacks par référence. Introduit un wrapper
    StaticDecoderConf avec conversion consteval afin de refuser une configuration
    automatique, temporaire ou allouée dans le tas à son point de construction.
    Les fabriques intermédiaires transmettent le wrapper vérifié par valeur.
    La configuration statique actuelle de GpsUBX reste compatible. Le décodeur
    conserve une seule référence et peut toujours être alloué dynamiquement.
    Ajoute une cible de test avec six cas acceptés et cinq cas refusés, ainsi
    que la documentation du contrat de l'API.
    Validation : make -C microcan test_ubx_config_lifetim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
2026-09-23 Importe les corrections I2C/ADC et trois rôles capteurs indépendants
    Récupère la récupération du bus I2C et la correction de lecture ADC
    depuis imav2026. Ajoute les rôles IM68A130, OPT4060 et VL53L4CX,
    désactivés par défaut, avec paramètres et télémétrie propres.
    Alloue les contextes, buffers DMA et piles des threads à l'activation.
    Déplace les buffers ST modifiables dans le contexte dynamique du capteur
    et documente l'empreinte statique résiduelle ainsi que le partage I2C.
    Intègre les sources ST avec leur licence et leur provenance.
    Validation : compilation firmware et bootloader, configurations capteurs
    individuelles et désactivées, contrôle ELF, tests de décodage c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
    [I2C_periph.cpp, I2C_periph.hpp, UAVCanSlave.cpp, adcSurvey.cpp, mcuconf.h, microphoneRole.cpp, microphoneRole.hpp, nodeParameters.hpp]
2026-09-23 Ajoute le spectre microphone compact (non testé sur matériel)
    Remplace les statistiques KeyValue du microphone par une FFT 512 points
    avec fenêtre de Hann et sélection des dix bins les plus forts entre
    100 Hz et 3 kHz. La mémoire FFT est allouée uniquement à l'activation.
    Définit microcan.audio.Spectrum avec fréquence et niveau logarithmique
    sur uint16. Sa capacité générique de 255 bins découle de la limite de
    transfert libcanard de 1023 octets. La publication de dix bins utilise
    42/43 octets et un encodeur borné, sans réserver les buffers maximaux.
    Documente la référence ADC du niveau, le format et le décodage côté réception.
    Statut : NON TESTÉ SUR MATÉRIEL. Aucun e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
2026-09-24 Généralise le rôle OPT4060 (validation matérielle requise)
    Remplace les publications opt.* KeyValue par microcan.light.Measurement.
    Déduit les modes synchrone et événementiel de publish_hz et scan_hz et
    calcule automatiquement le temps de conversion selon le budget I2C.
    Ajoute les seuils absolu/relatif, le heartbeat et la conservation d'un
    événement en attente, y compris en cas d'échec de mise en file CAN.
    Centralise les schémas audio/lumière dans UAVCAN/DSDL sur minican et utilise
    les codecs partagés de UAVCAN/DSDLC. Supprime les copies locales et inscrit
    cette contrainte dans AGENTS.md. Documente la migration de period_ms.
    Validation logicielle : tests capteurs, événements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
2026-09-25 Fix DShot telemetry units for DroneCAN
    [escDshotRole.cpp, escDshotRole.hpp, nodeParameters.hpp, role_telemetry_test.cpp]
2026-09-25 Publish fresh DShot telemetry and FlexDebug stress
    Publish NaN for unavailable or expired voltage, current and temperature. Send accumulated EDT stress maxima and status events in a documented MicroCAN FlexDebug v1 payload, at most 10 Hz per ESC, retaining pending diagnostics on CAN queue rejection. Increase the EDT worker stack for the generic FlexDebug encoder.
    Requires COMMON/various commit 94b52e7d1 for telemetry validity and age metadata.
    Validation: MicroCAN firmware build; host UBSan tests for role variants, per-field expiry, serial errors, event aggregation/retry, float16 NaN and shared FlexDebug codecs. Hardware validation remains pending.
    [escDshotRole.cpp, escDshotRole.hpp, role_telemetry_test.cpp, run.py, telemetry_metadata_test.cpp, telemetry_test_support.hpp, telemetry_wire_test.c]
2026-09-25 Add regression coverage for bidirectional DShot decoding
    Exercise the actual shared capture decoder and eRPM codec under UBSan for all 4096 payloads, timestamp wraparound and jitter, CRC errors, invalid captures and stopped motors. Document the boundary between host coverage and hardware DMA validation.
    [run.py]
2026-09-25 Archive the local WS2812 system-lock implementation
    Preserve the existing alternative LED implementation without changing its contents or selecting it in the firmware build.
2026-09-25 Save IMAV parameters and sensor documentation
    Preserve the local DroneCAN parameter snapshot and sensor document. The JSON parses and the ODT archive passes its integrity check. Video and raw CSV recordings remain local.
2026-09-25 Keep UAVCAN reachable in identification mode and add optional shell role
    Preserve configured shell access during identification while suspending other roles without changing their parameters. Allocate console state and thread stacks on activation, retain NOSHELL builds, and add startup/allocation regression tests and a role-by-role bench procedure.
2026-09-26 Allow live identification with adaptive LED timing
